LawranceSim/AQUASS-Flood-Detection-Alert-System/docs/System Design Project Portfolio (Group 7, AQUASS).pdf

4

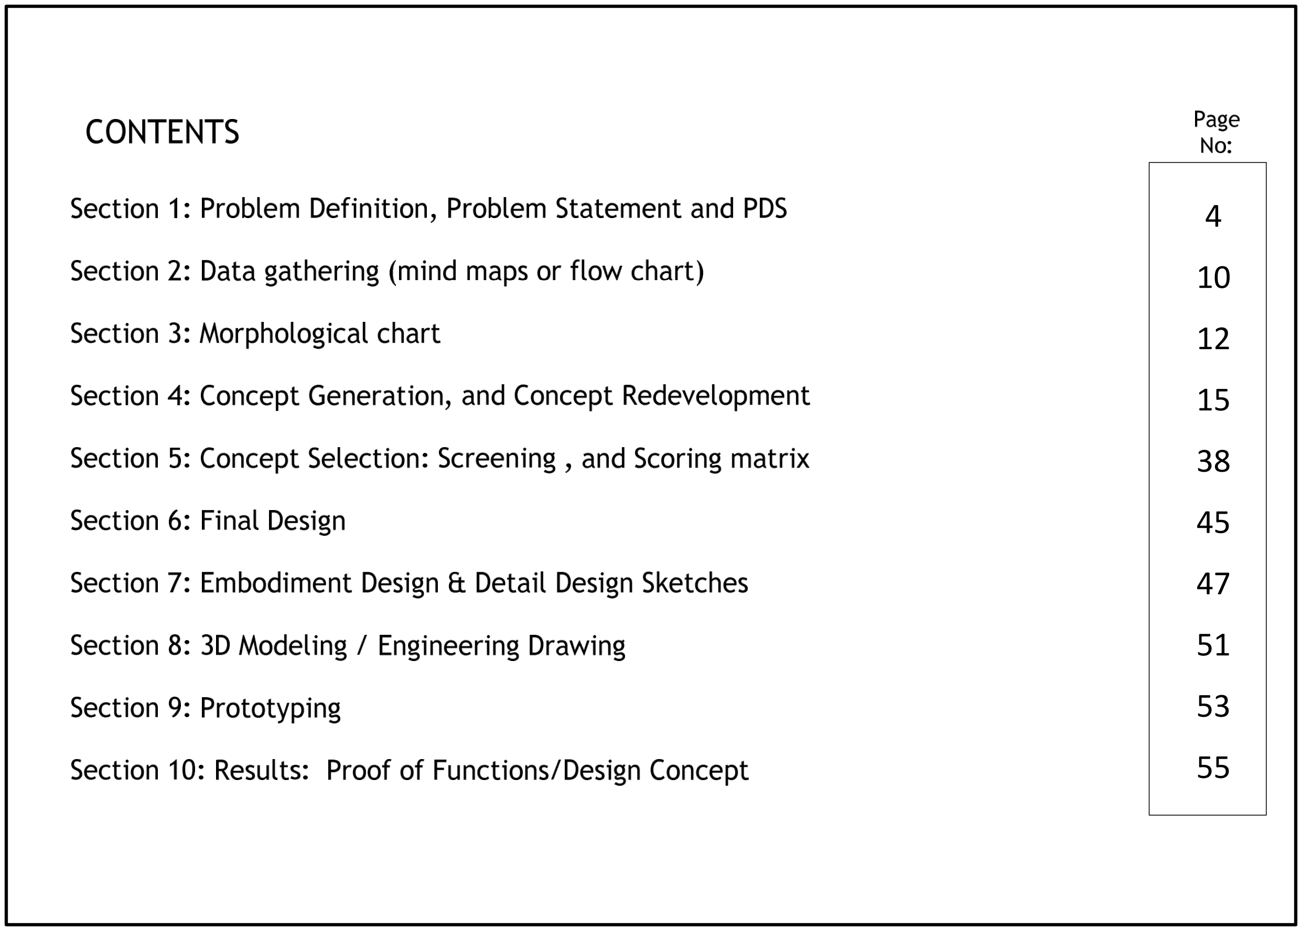
[picture p4: page 1]

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
## Problem Definition

## Design Project: Camper Site Flooding Safety System

## Project Background

## Campsites located near rivers, lakes, or low-lying areas face flooding risks, especially during heavy rainfall. Flooding can damage camping equipment, disrupt activities, and endanger campers. To improve safety, innovative design solutions are needed that are

practical, portable, and reliable in outdoor environments.

## Project Task

The primary objective of this project is for you to design and develop a solution that enhances the safety of campers during flooding events. The system should either pre vent or mitigate flooding risks at campsites, using a combination of mechanical engi neering solutions, Internet of Things (IoT) technology, or a hybrid of both. The solution will need to be practical, cost-effective, and scalable for real-world use

## Problem Statement

## The primary issue addressing this project is the critical absence of real-time, on-site monitoring systems at campsites. Current flood alert mechanisms operate on a macro scale, providing broad regional warnings that lack the granularity required for specific

campsite safety. This lack of localized data creates a significant notification delay, often

referred to as latency, between the onset of rising water levels and the reception of a warning. Consequently, campers are left with insufficient time to react, rendering them unable to evacuate before water levels become hazardous. This delay significantly increases the risk of entrapment, property damage, and casualty during flash flood

events.

To mitigate these risks, the proposed solution is the "AQUASS" system—a rugged IoT-based device designed specifically for continuous lakeside monitoring. The system is engineered to perform real-time water level analysis and autonomously execute a decision-making process based on safety thresholds. The core design philosophy focuses on a dual-alert mechanism that integrates immediate local sirens for on-site campers and remote Blynk notifications for off-site operators or authorities. This approach ensures reliable, all-weather operation and provides a redundant warning system to guarantee that alerts are received regardless of the campers' immediate

attentiveness.

Category | Specification | Description / Target / Rationale
Function | Flood detection and early warning | Detects rising water levels near campsites and triggers alerts for evacuation.
Application Area | Campsite or recreational sites near lakes | Fixed installation near potential flood-prone zones.
Performance requirements | Detection range | Detects water-level rise within 0–200 cm range with ±2% accuracy.
| Response time | Alert within ≤ 5 seconds after the danger threshold exceeded.
| Alert coverage | Local alert (LED, buzzer) audible within 30 m radius.
Power Requirement | Supply | 12V DC (solar + Li-ion battery backup).
| Operation time | Minimum 7 days continuous operation without sunlight.
| Power consumption | < 1.5 W average (low-power IoT mode).
Dimensions | Pole height | ≥ 1m
| Casing | Length ≤50 cm Width ≤50 cm Height ≤50 cm
Communication / Connectivity | Local and remote alerts | GSM or LoRa for off-grid sites; Wi-Fi optional where available.
| IoT integration | Blynk / ThingSpeak for data monitoring and notifications.

## Product Design Specifications (PDS)

Materials and Construction | Enclosure | Weatherproof IP65+ ABS/polycarbonate enclosure.
| Mounting | Fixed installation on pole or platform near riverbank.
| Environmental protection | UV-resistant, waterproof, and corrosion-proof materials.
Safety Requirements | Electrical safety | All low-voltage operation (≤12V DC).
| Environmental safety | Non-toxic, sealed components; no hazardous emissions.
| Human safety | Visual and audible alerts comply with campsite noise limits (<80 dB).
| Structural safety | Safety factor of the most critical point of the structure >3.5
Environmental Conditions | Operating temperature | 0°C to 60°C.
| Humidity | 10–95% RH, non-condensing.
| Weather resistance | Must function during heavy rain, humidity, and minor debris exposure.
Reliability and Maintenance | Reliability | System uptime ≥ 95% during continuous monitoring.
| Maintenance | Annual battery inspection; sensor calibration every 6 months.
| MTBF (Mean Time Between Failures) | ≥ 5000 hours.
Ergonomics and Usability | User interface | Simple visual indicator (LED status) and mobile notification.
| Installation | Quick installation (≤ 6 hours) with minimal tools and instructions.
| Accessibility | Accessible maintenance port with waterproof seals.
Aesthetic / Design Factors | Design form | Compact and have eye-catching colour such as white.
| Visibility | LED indicators visible in daylight and night.

Standards / Compliance | Electrical & communication | Compliant with CE, FCC IoT, and IP65 standards.
| SDG alignment | Supports SDG 13 (Climate Action) and SDG 11 (Sustainable Communities).
Cost Target | Prototype cost | ≤ RM 400 per unit (excluding solar panel).
| Large-scale deployment | Target ≤ RM 500 per unit in production (excluding microcontroller / microprocessor, wirings).
Constraints | Location constraint | Installed within 1m from the water body for accurate monitoring.
| Power source constraint | Dependent on solar exposure; must ensure energy balance.
| Communication constraint | GSM coverage required if LoRa is not available.
Testing and Validation | Validation methods | Simulated flood tank testing, field trial at real campsite.
| Key performance indicators | Detection accuracy, alert reliability, power endurance, communication stability.

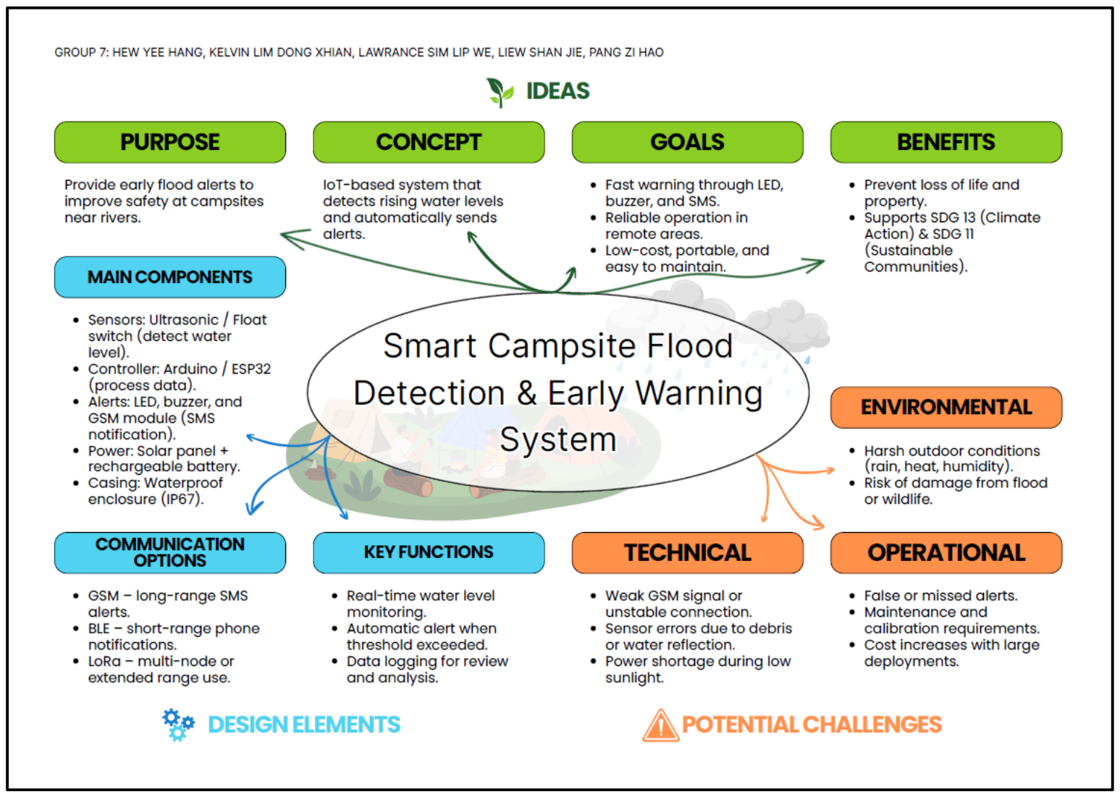
[picture p5: page 9]

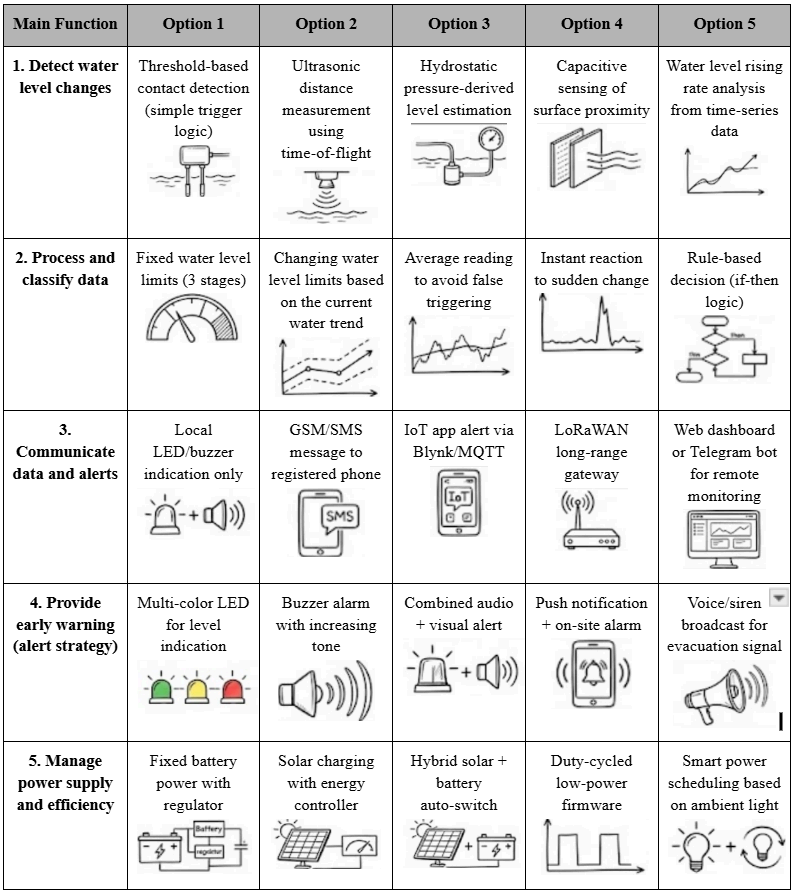
[picture p6: figure]

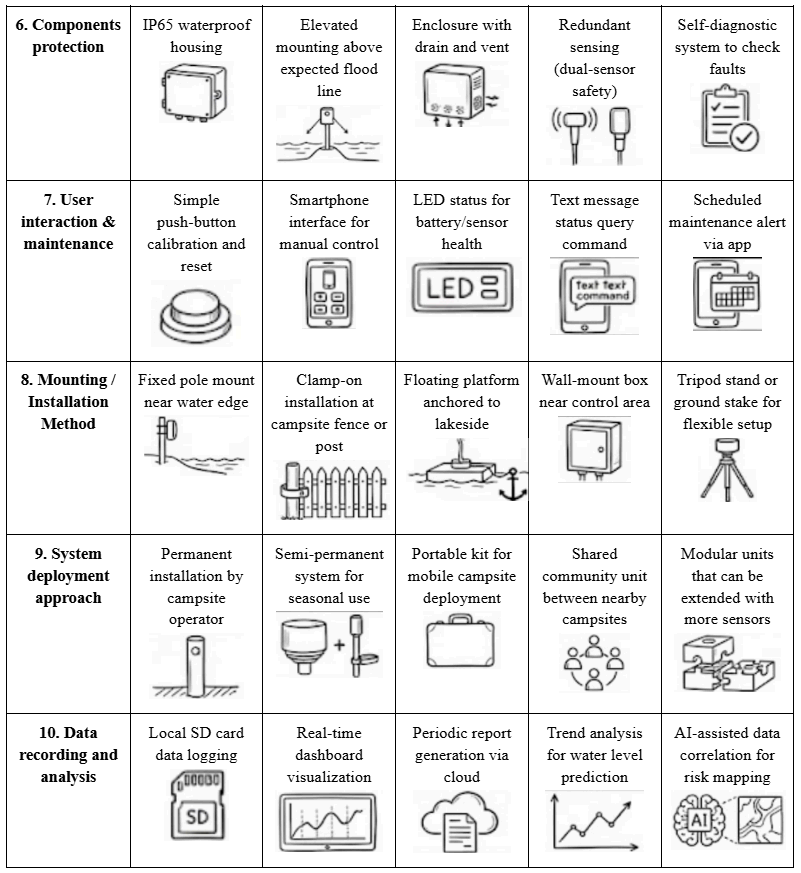
[picture p7: figure]

# Concept Generation

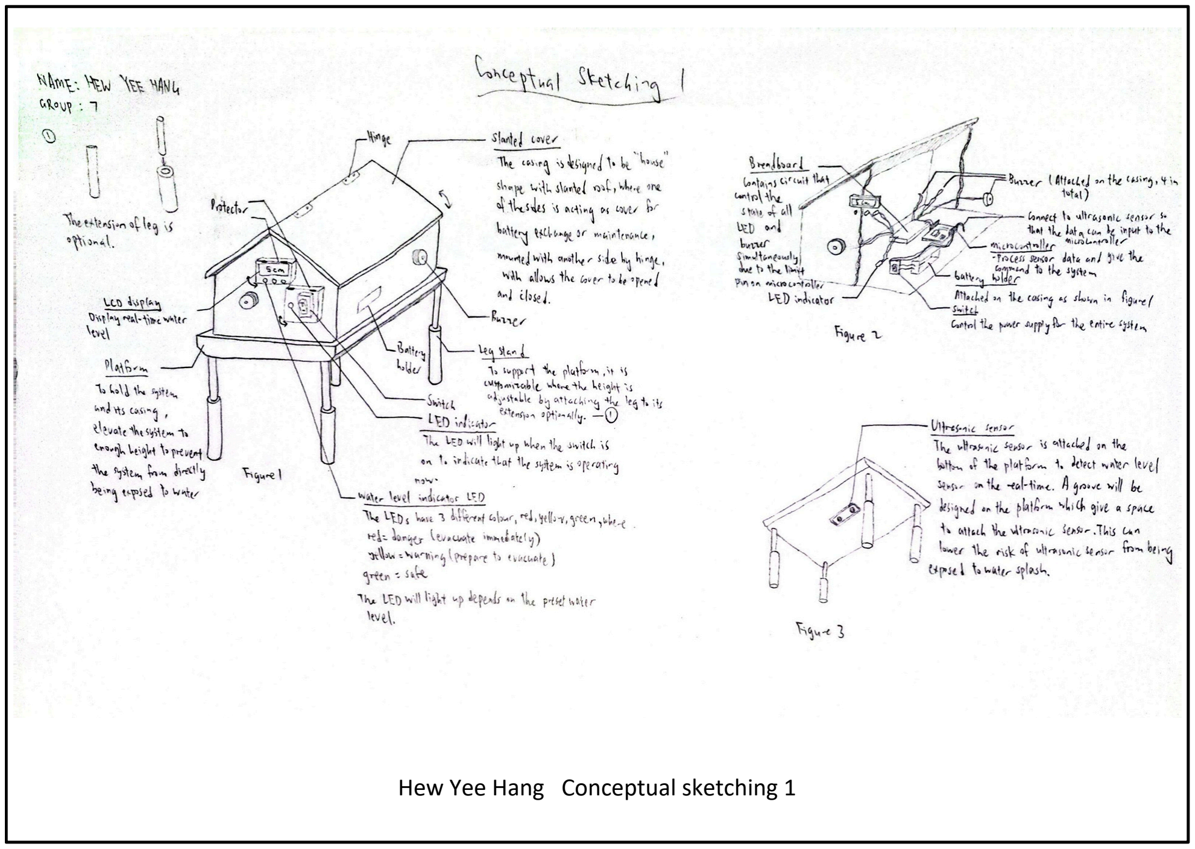
[picture p8: page 15]

Hew Yee Hang Conceptual sketching 1

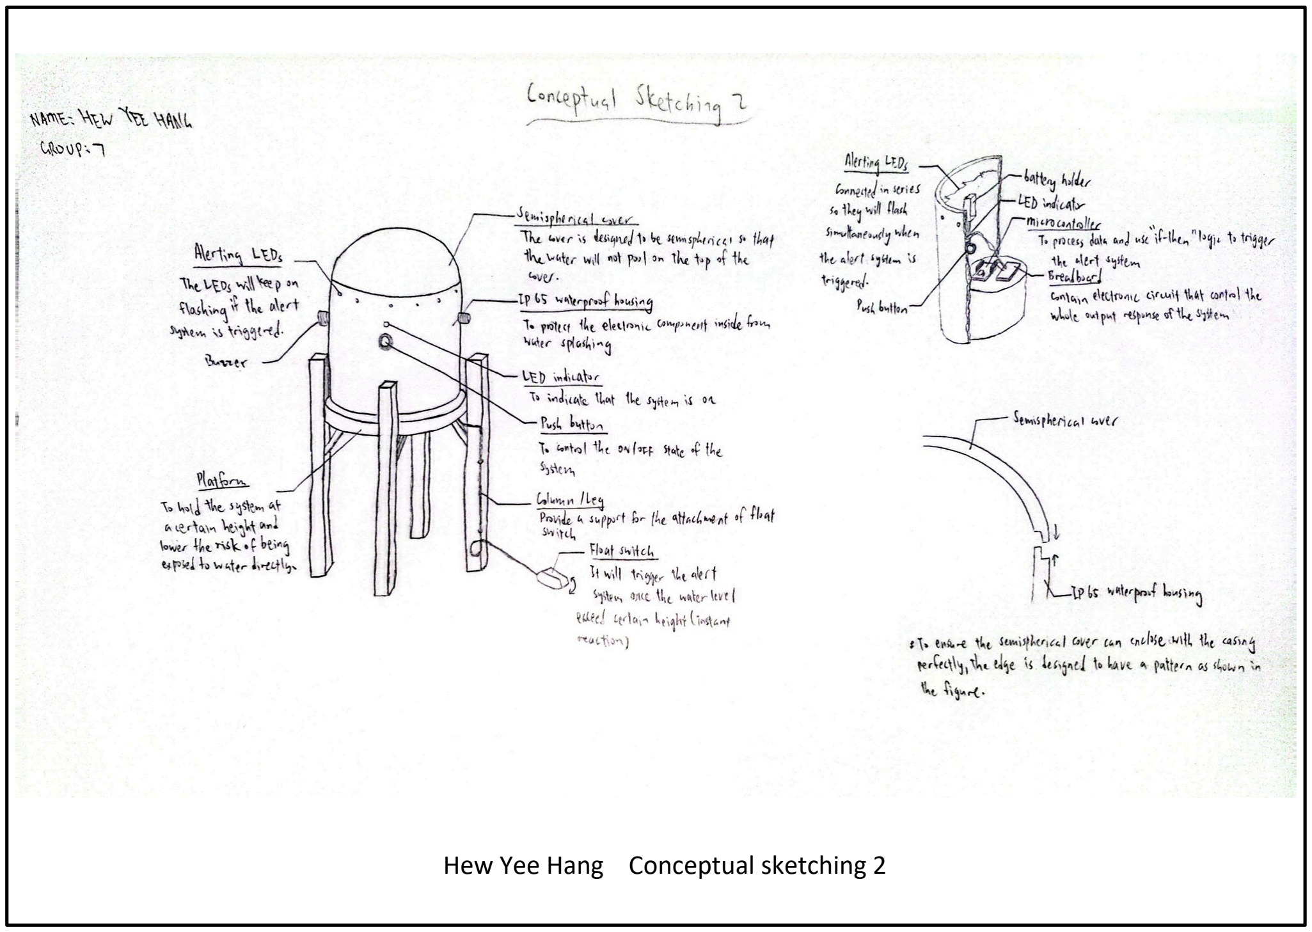
[picture p9: page 16]

Hew Yee Hang Conceptual sketching 2

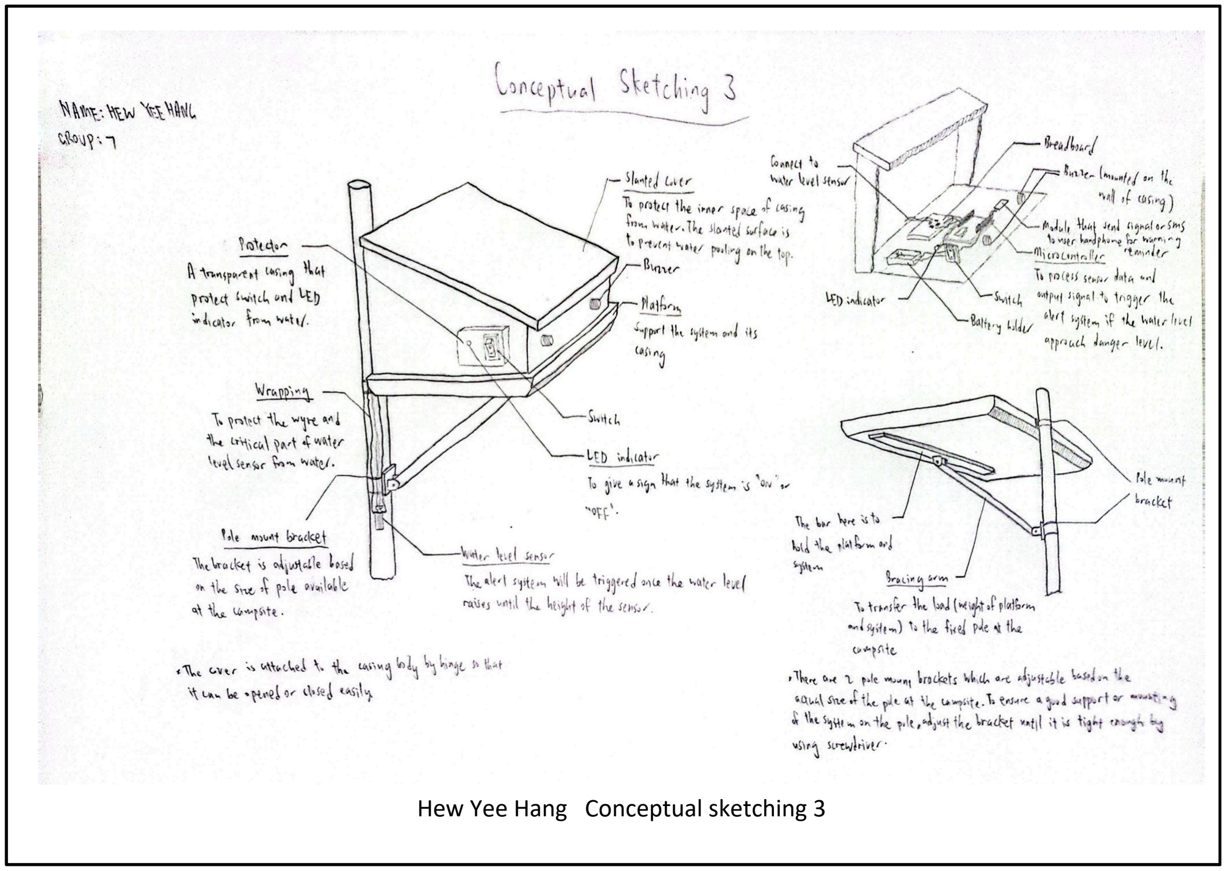
[picture p10: page 17]

Hew Yee Hang Conceptual sketching 3

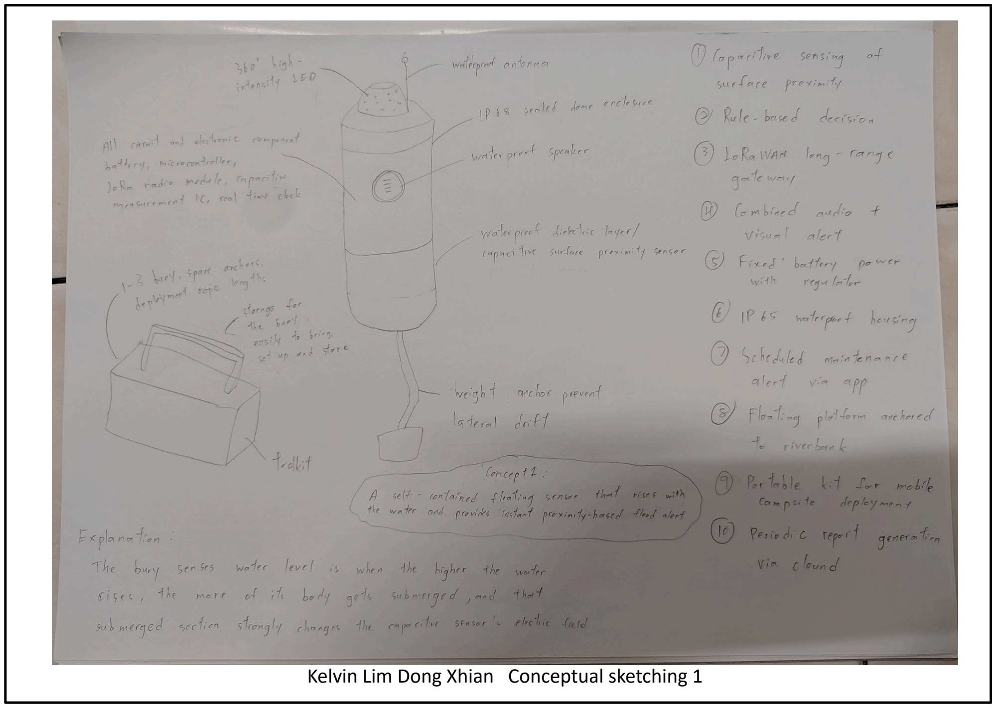
[picture p11: page 18]

Kelvin Lim Dong Xhian Conceptual sketching 1

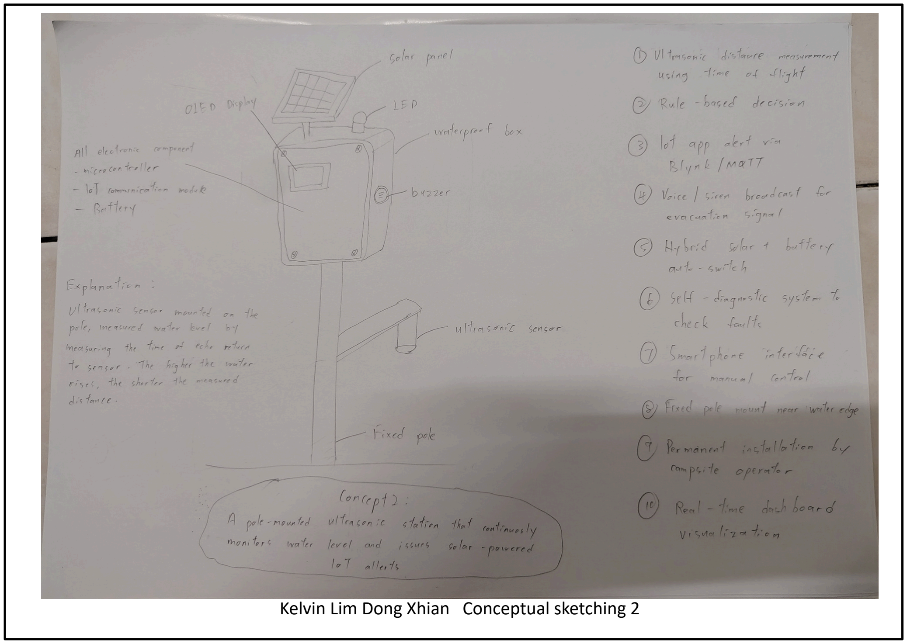
[picture p12: page 19]

Kelvin Lim Dong Xhian Conceptual sketching 2

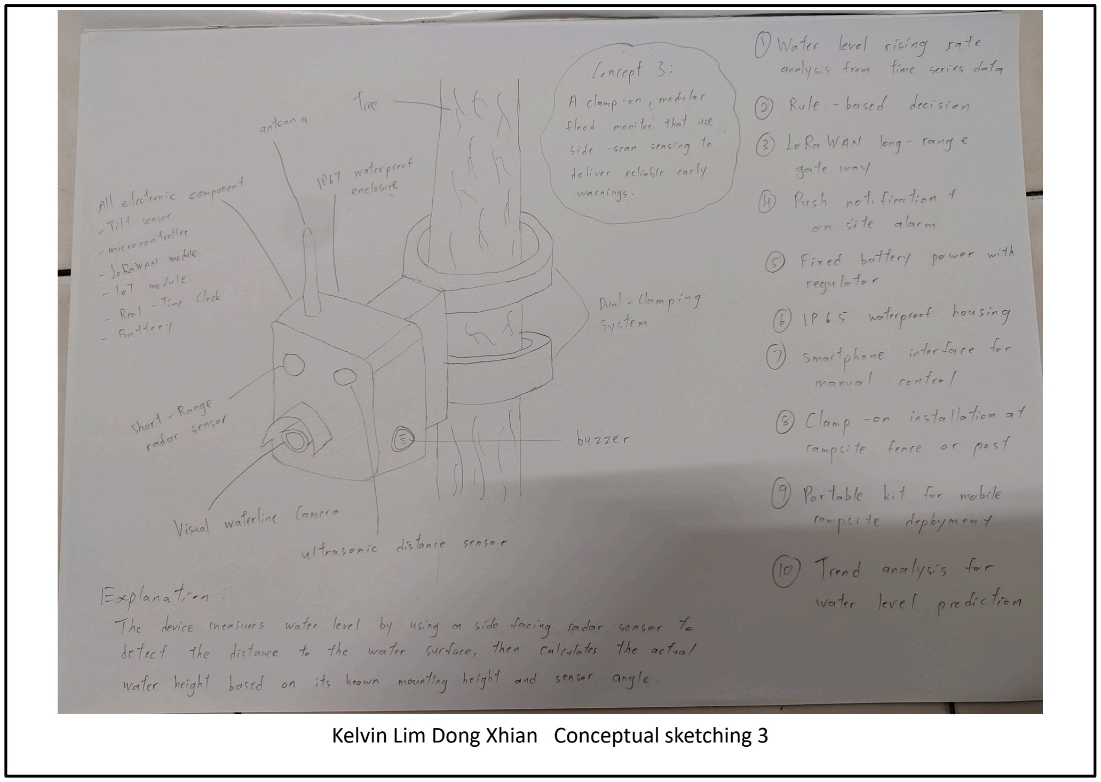
[picture p13: page 20]

Kelvin Lim Dong Xhian Conceptual sketching 3

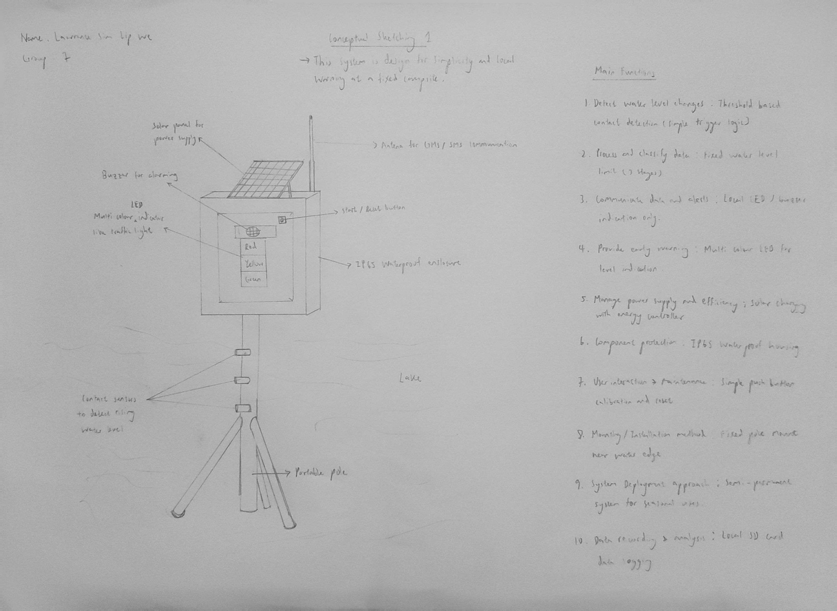
[picture p14: page 21]

Lawrance Sim Lip We Conceptual sketching 1

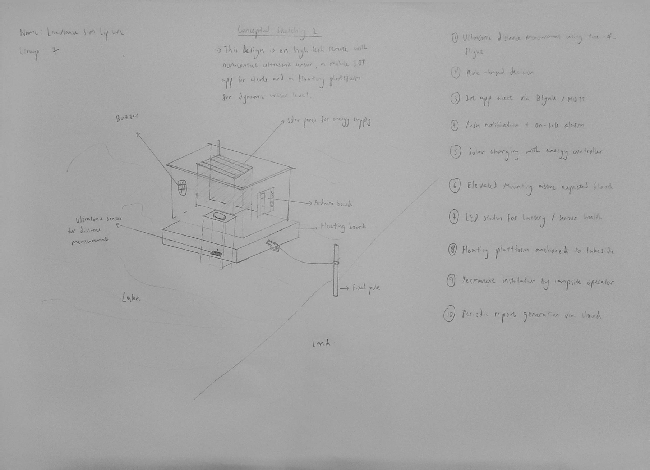
[picture p15: page 22]

Lawrance Sim Lip We Conceptual sketching 2

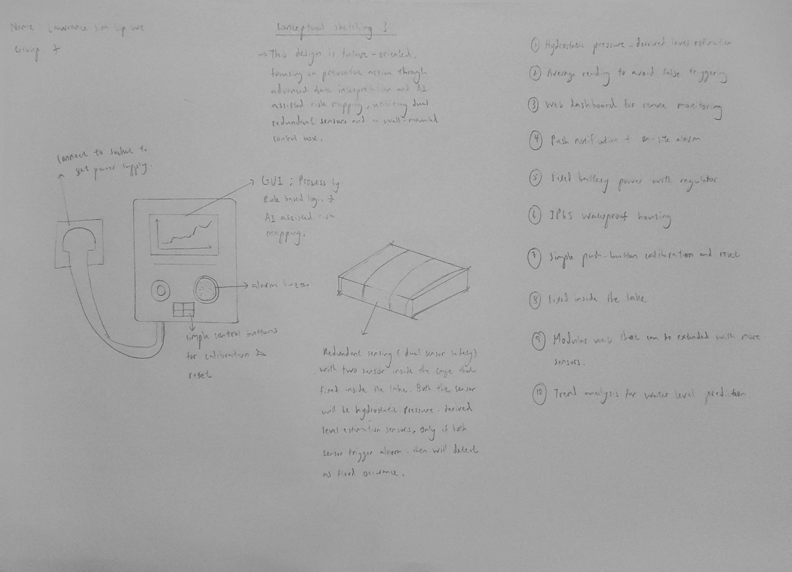
[picture p16: page 23]

Lawrance Sim Lip We Conceptual sketching 3

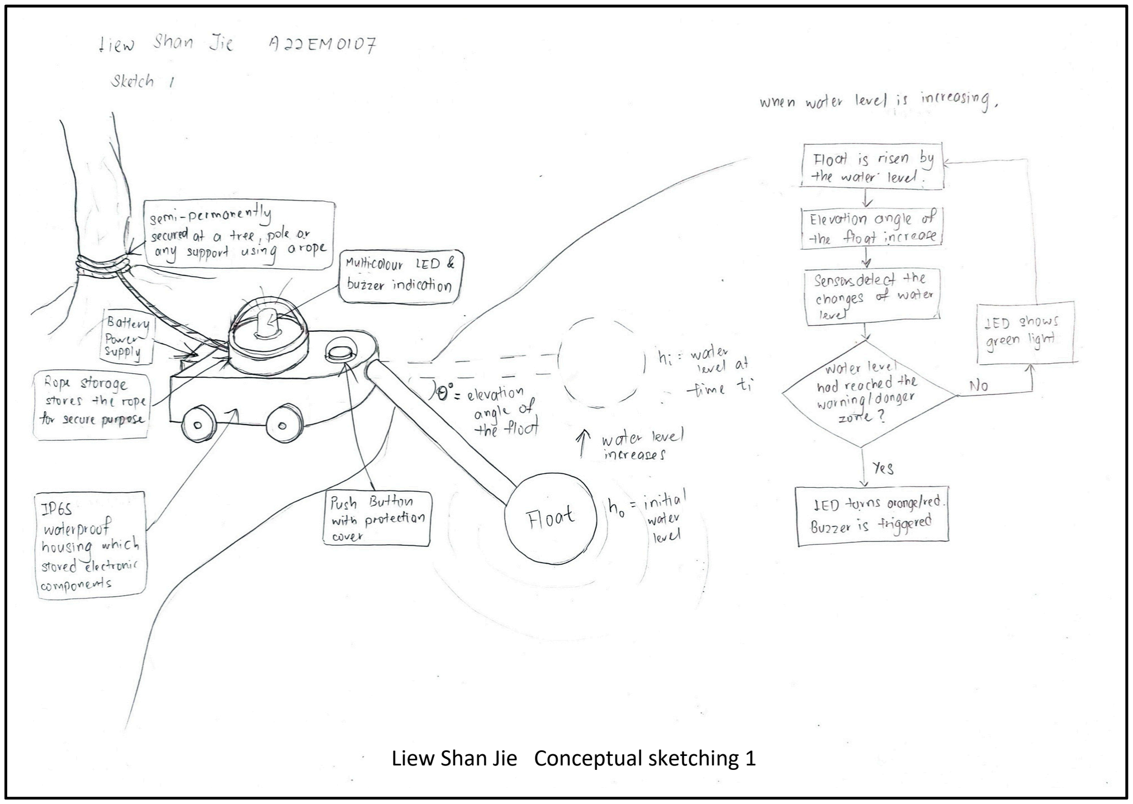
[picture p17: page 24]

Liew Shan Jie Conceptual sketching 1

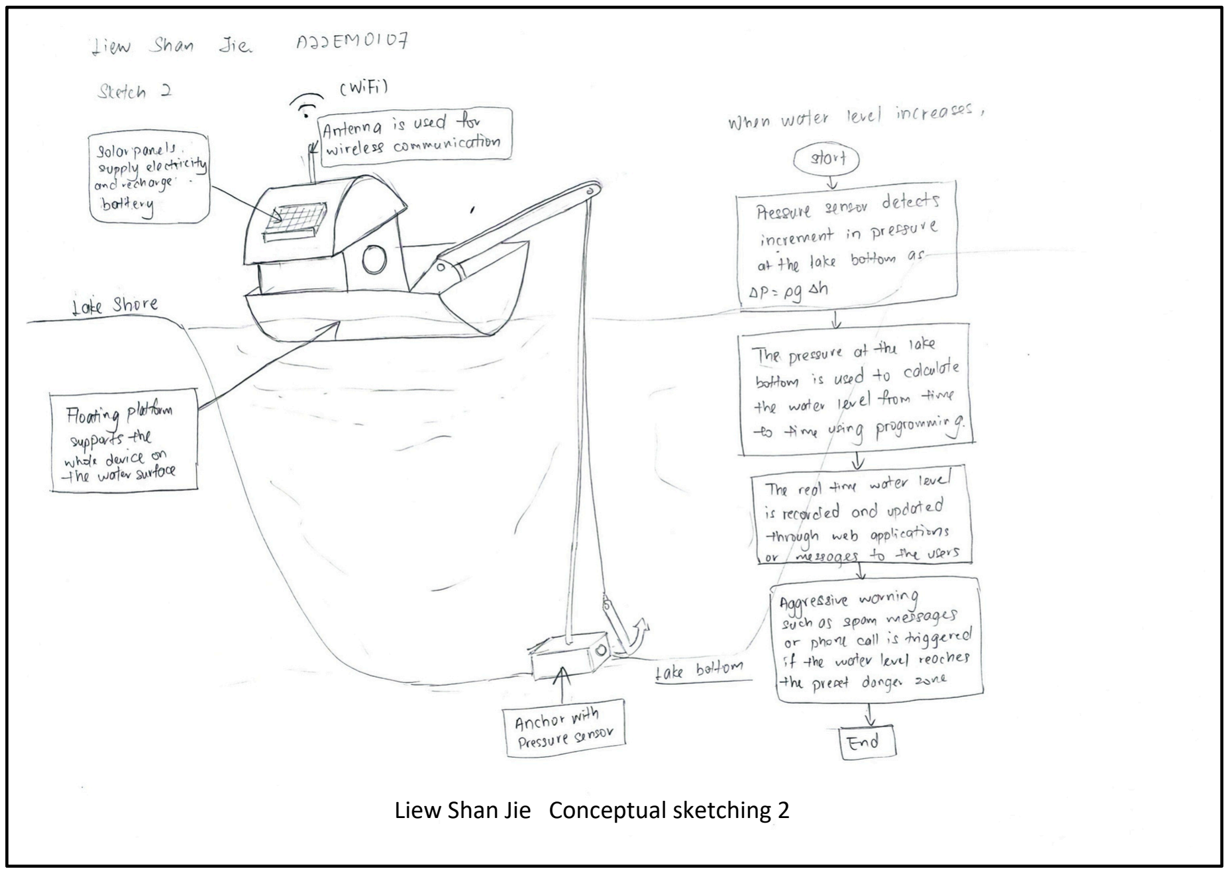
[picture p18: page 25]

Liew Shan Jie Conceptual sketching 2

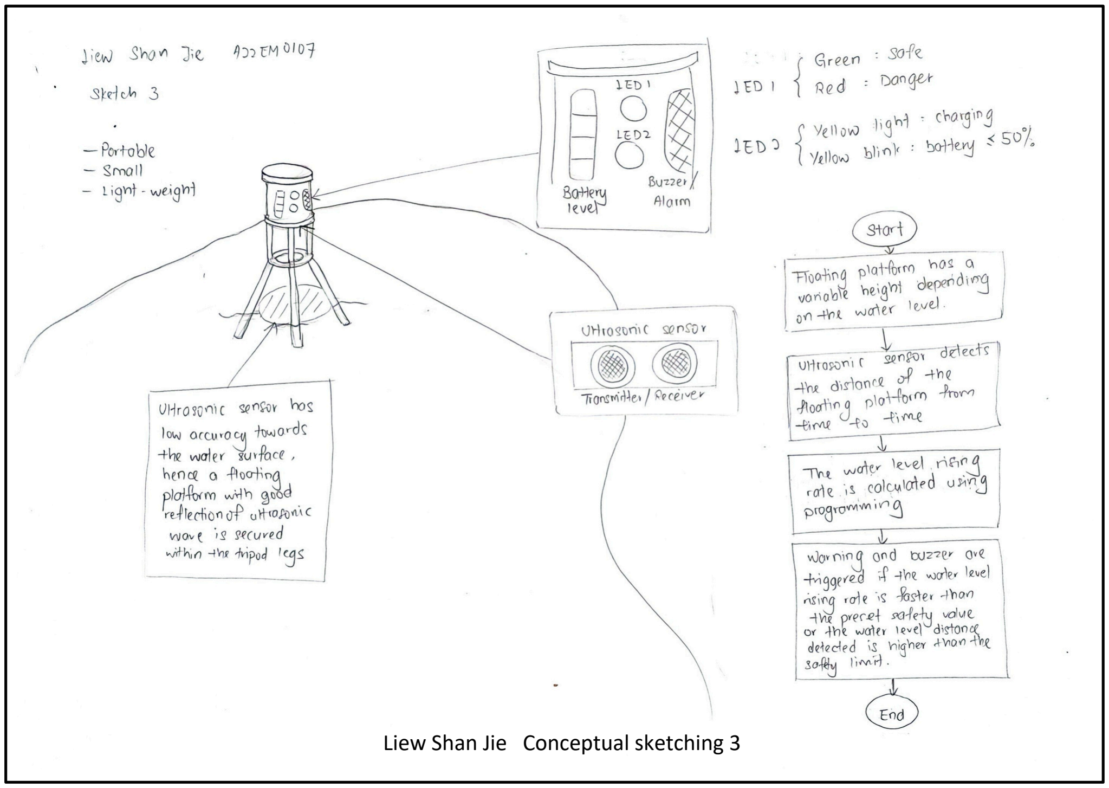
[picture p19: page 26]

Liew Shan Jie Conceptual sketching 3

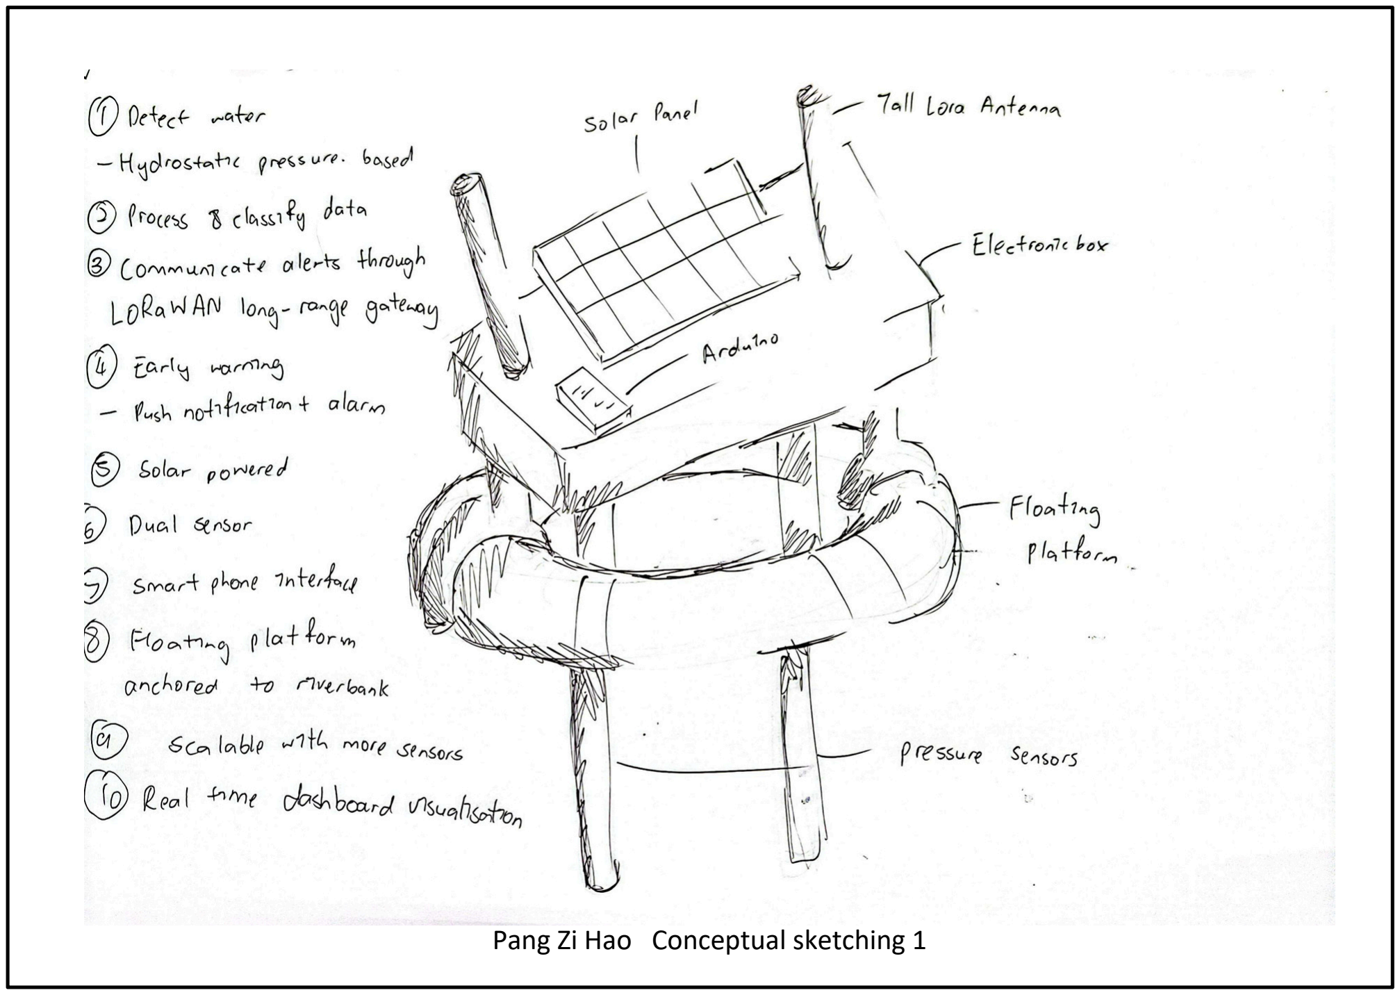
[picture p20: page 27]

Pang Zi Hao Conceptual sketching 1

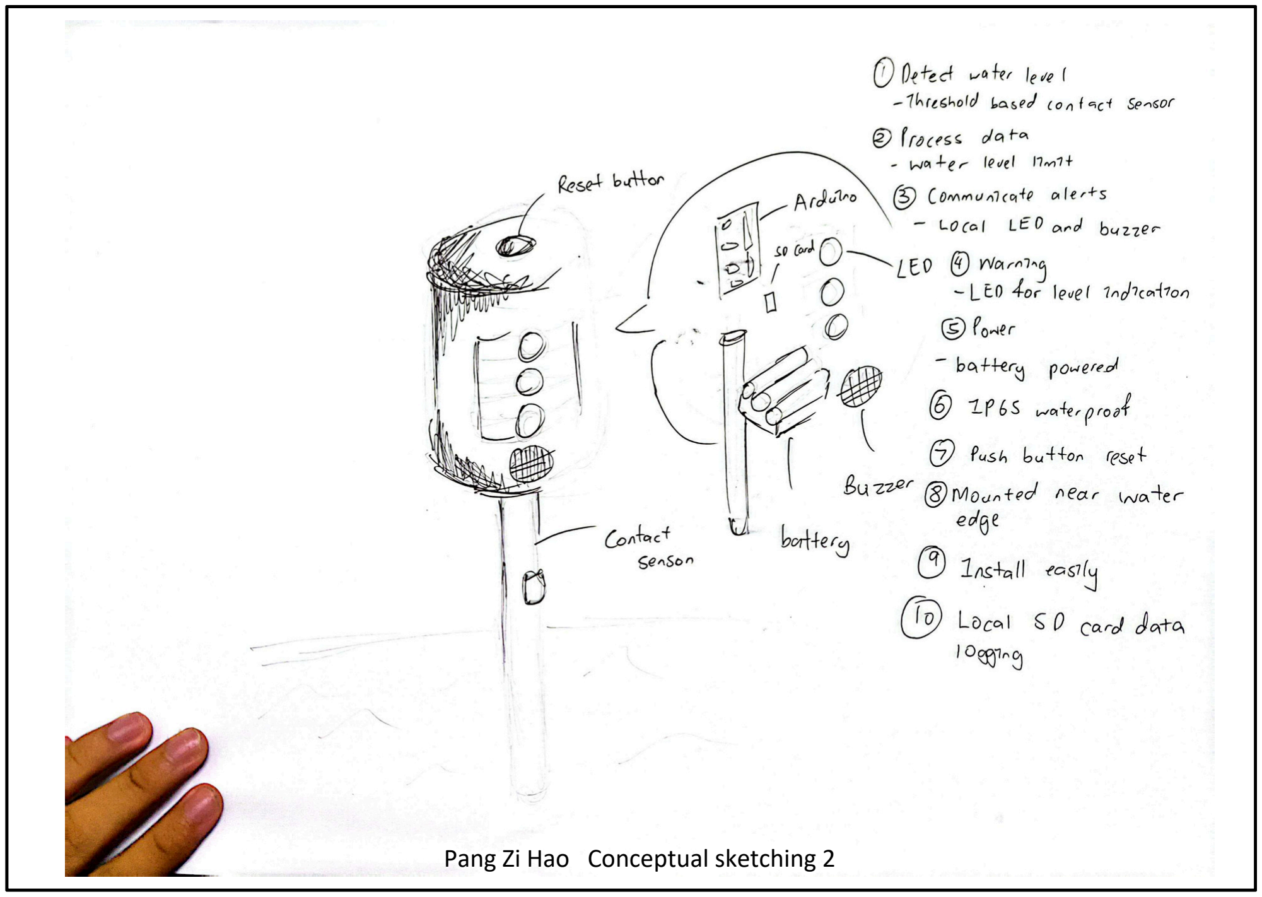
[picture p21: page 28]

Pang Zi Hao Conceptual sketching 2

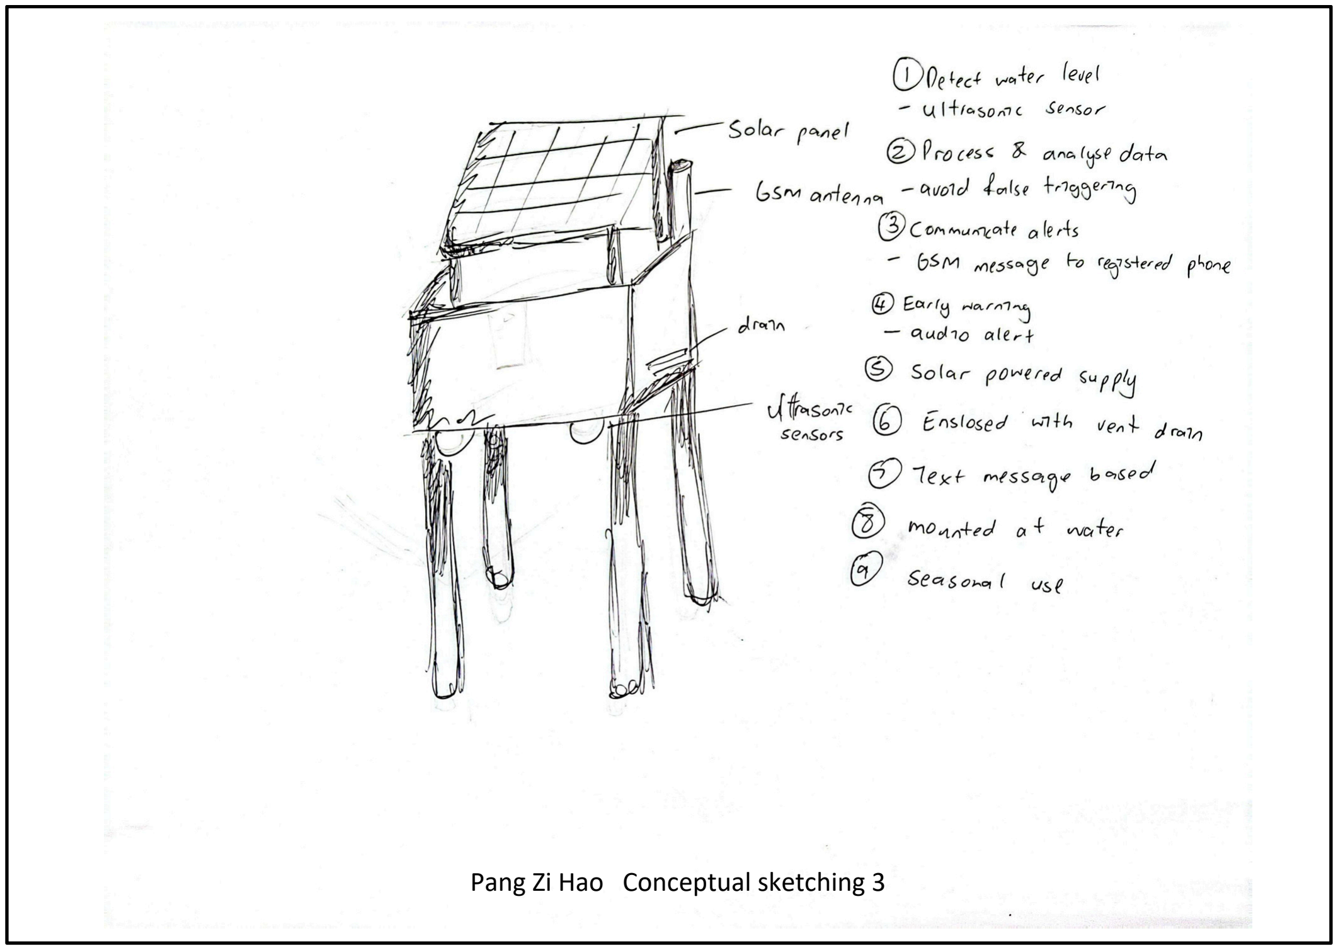
[picture p22: page 29]

Pang Zi Hao Conceptual sketching 3

# Concept Redevelopment

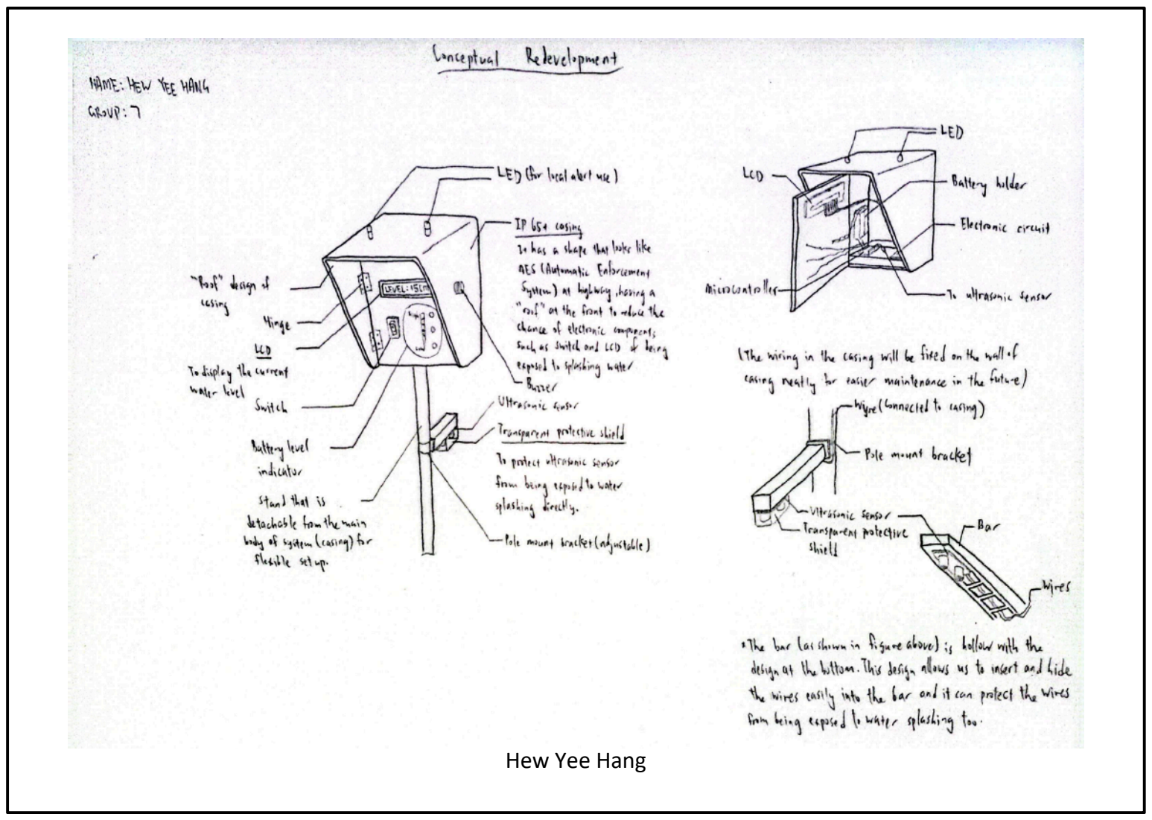
[picture p23: page 31]

Hew Yee Hang

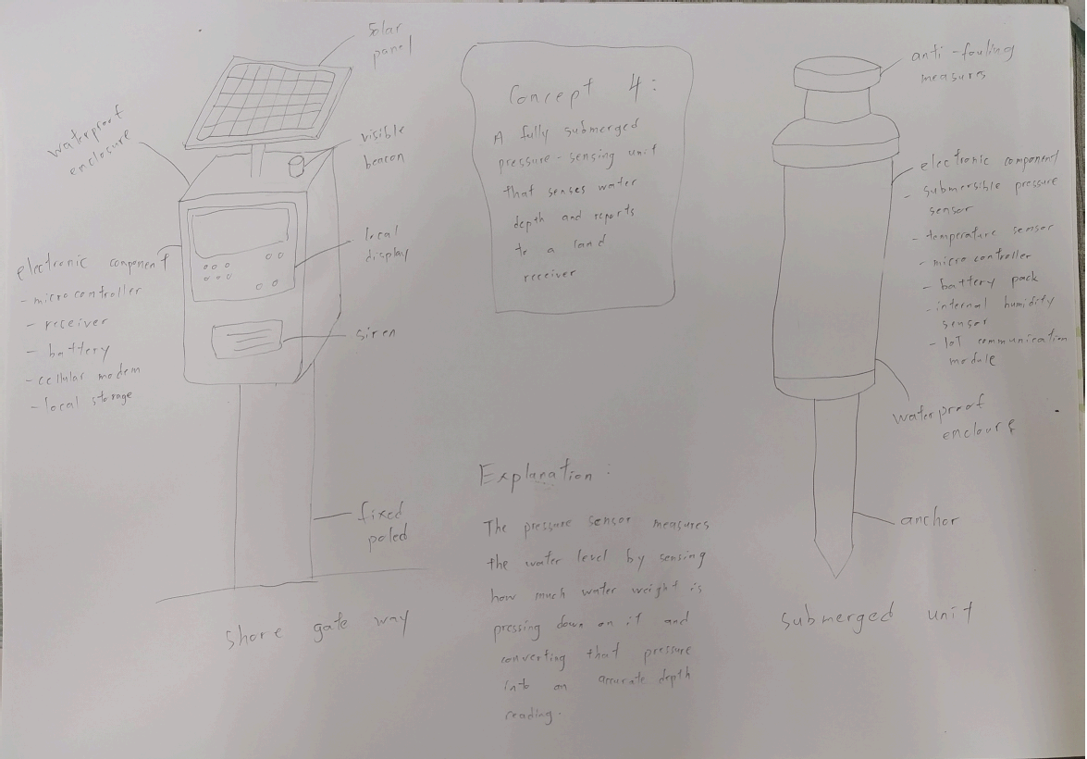
[picture p24: page 32]

Kelvin Lim Dong Xhian

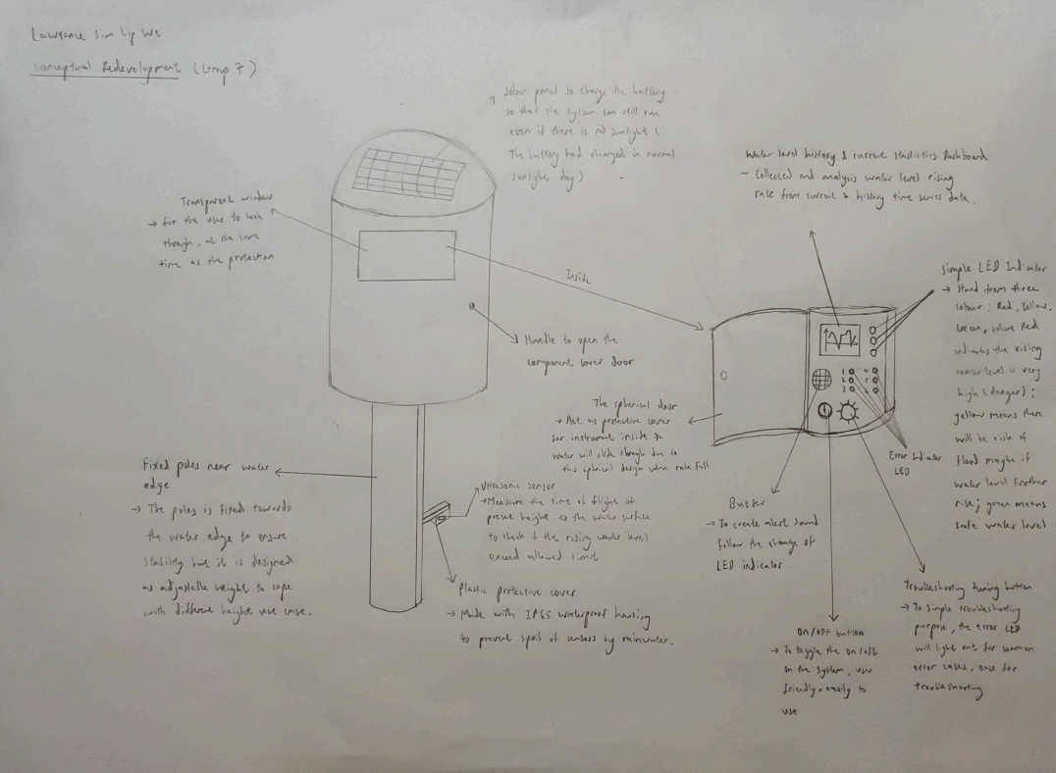
[picture p25: page 33]

Lawrance Sim Lip We

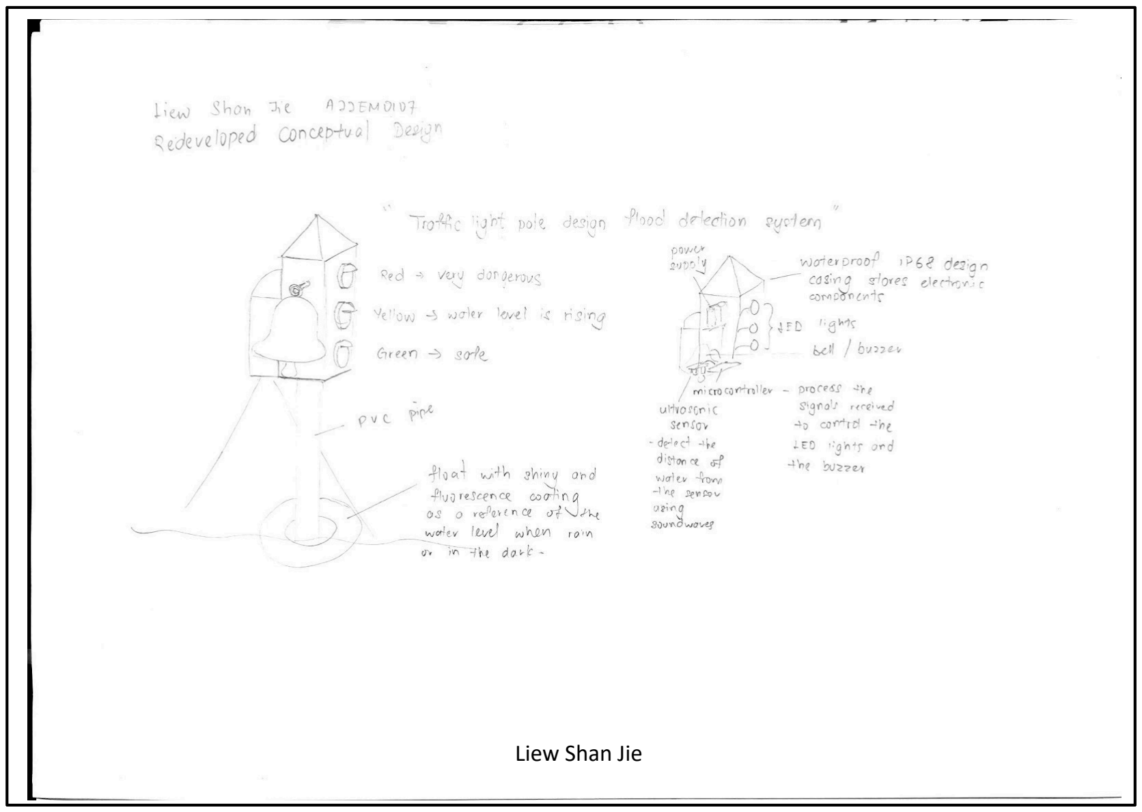
[picture p26: page 34]

Liew Shan Jie

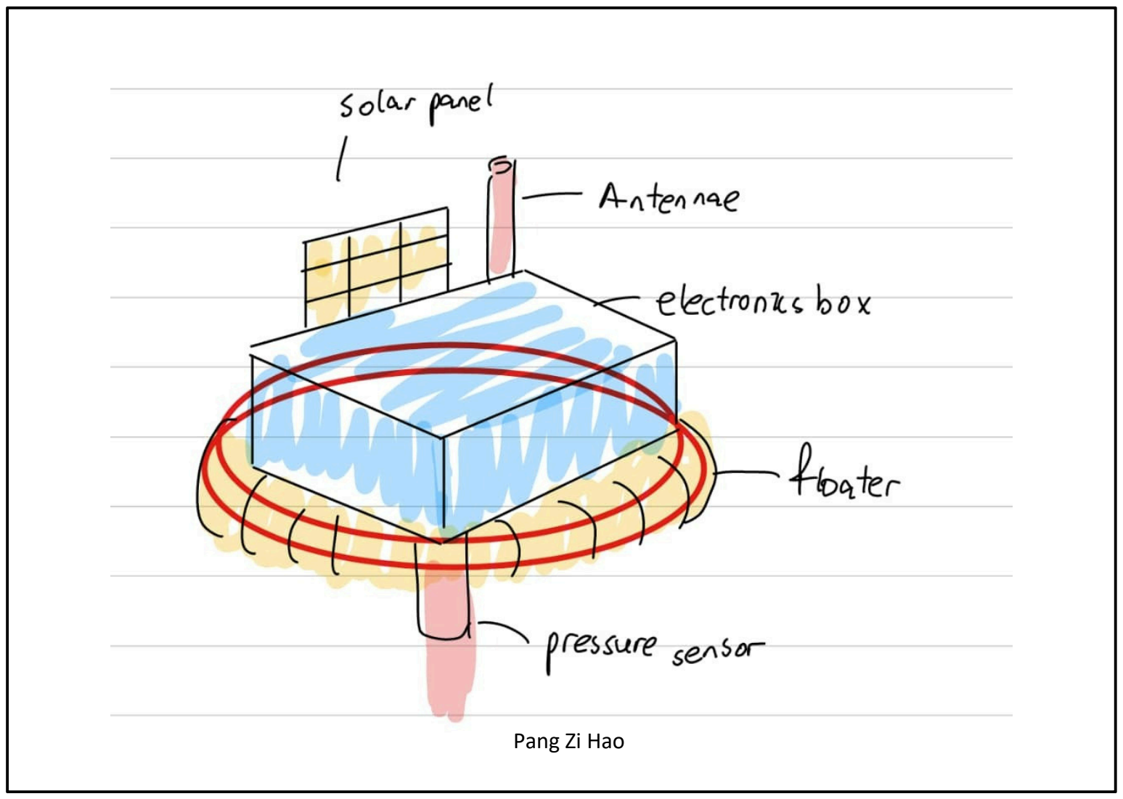
[picture p27: page 35]

Pang Zi Hao

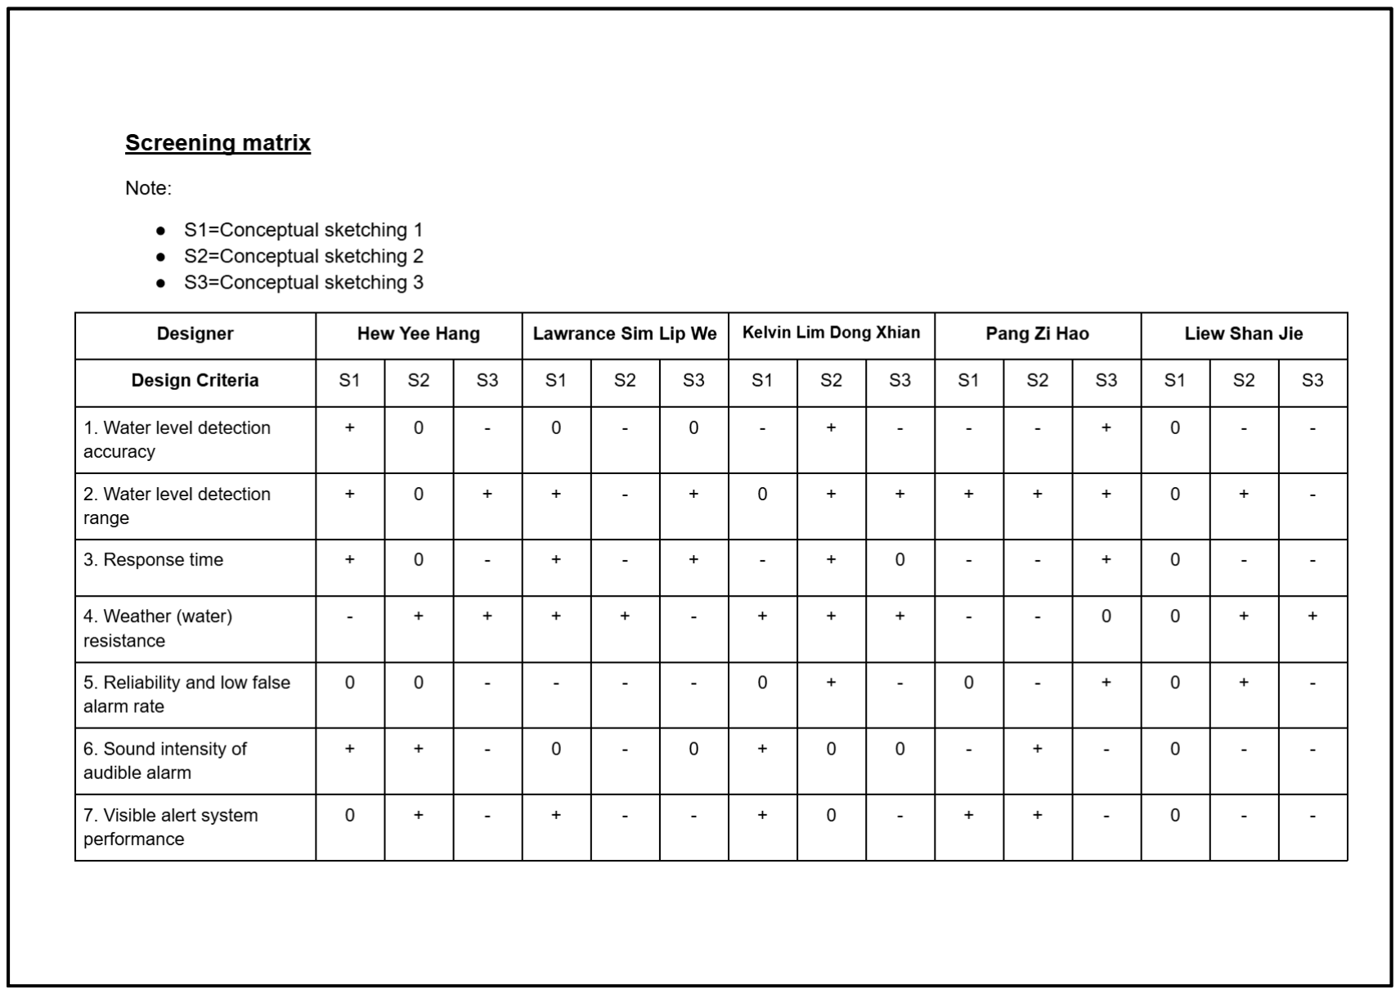
[picture p28: page 37]

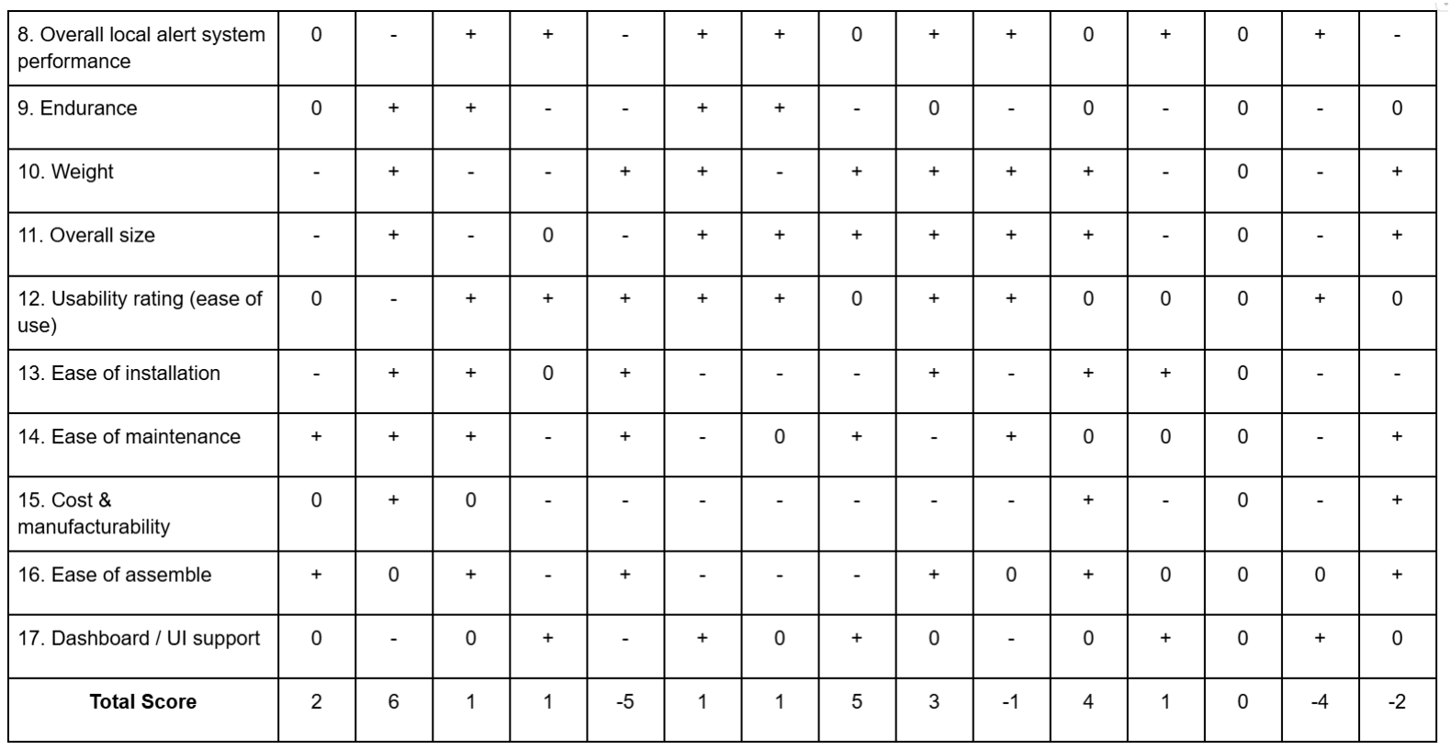
[picture p29: figure]
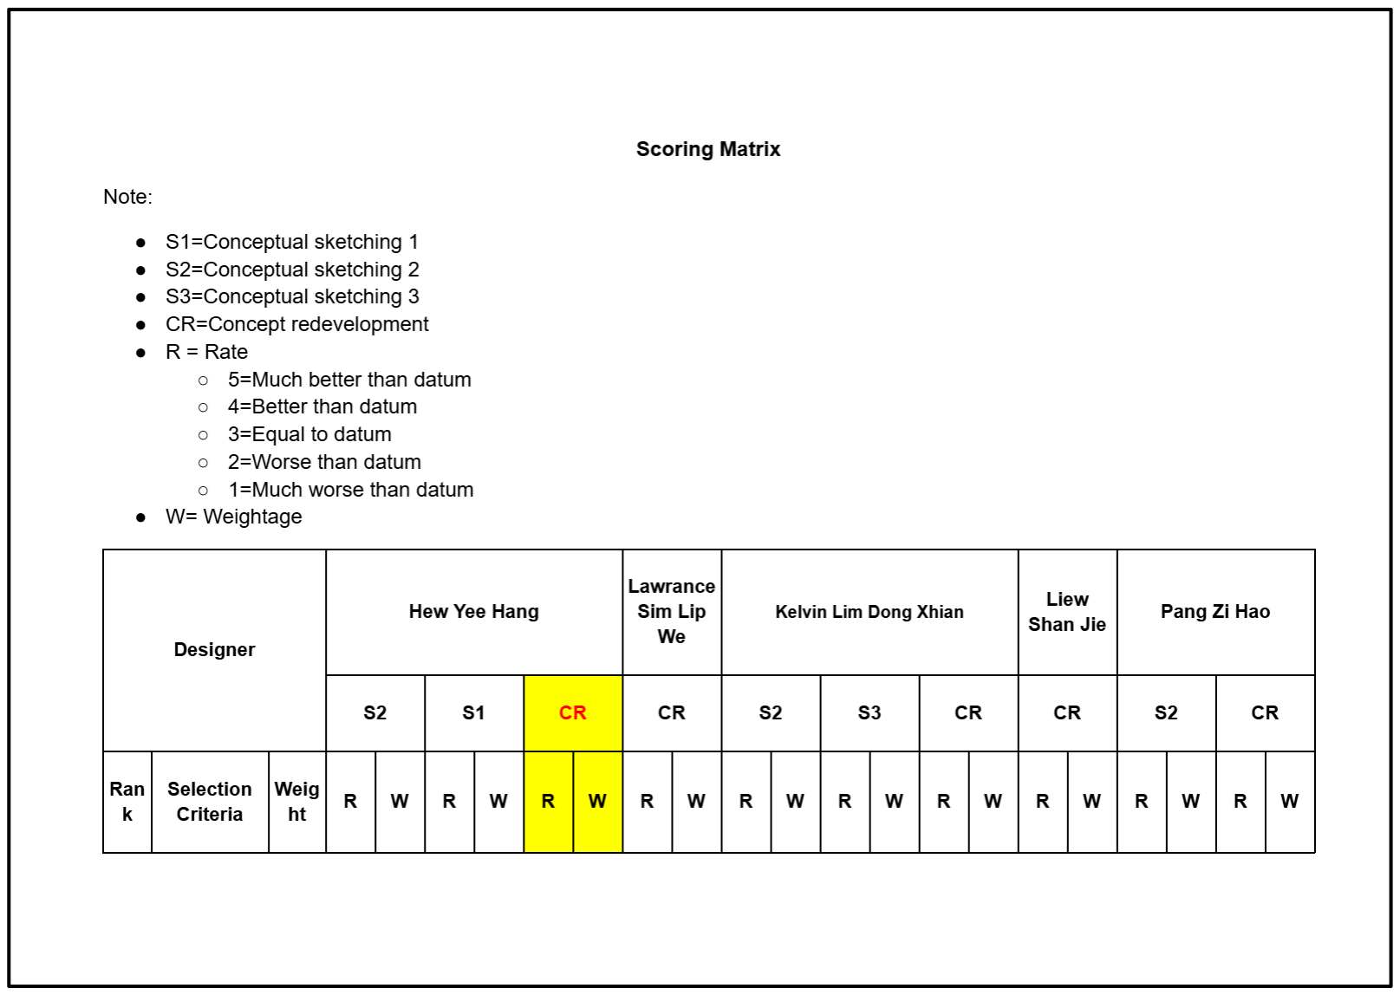
[picture p30: page 39]
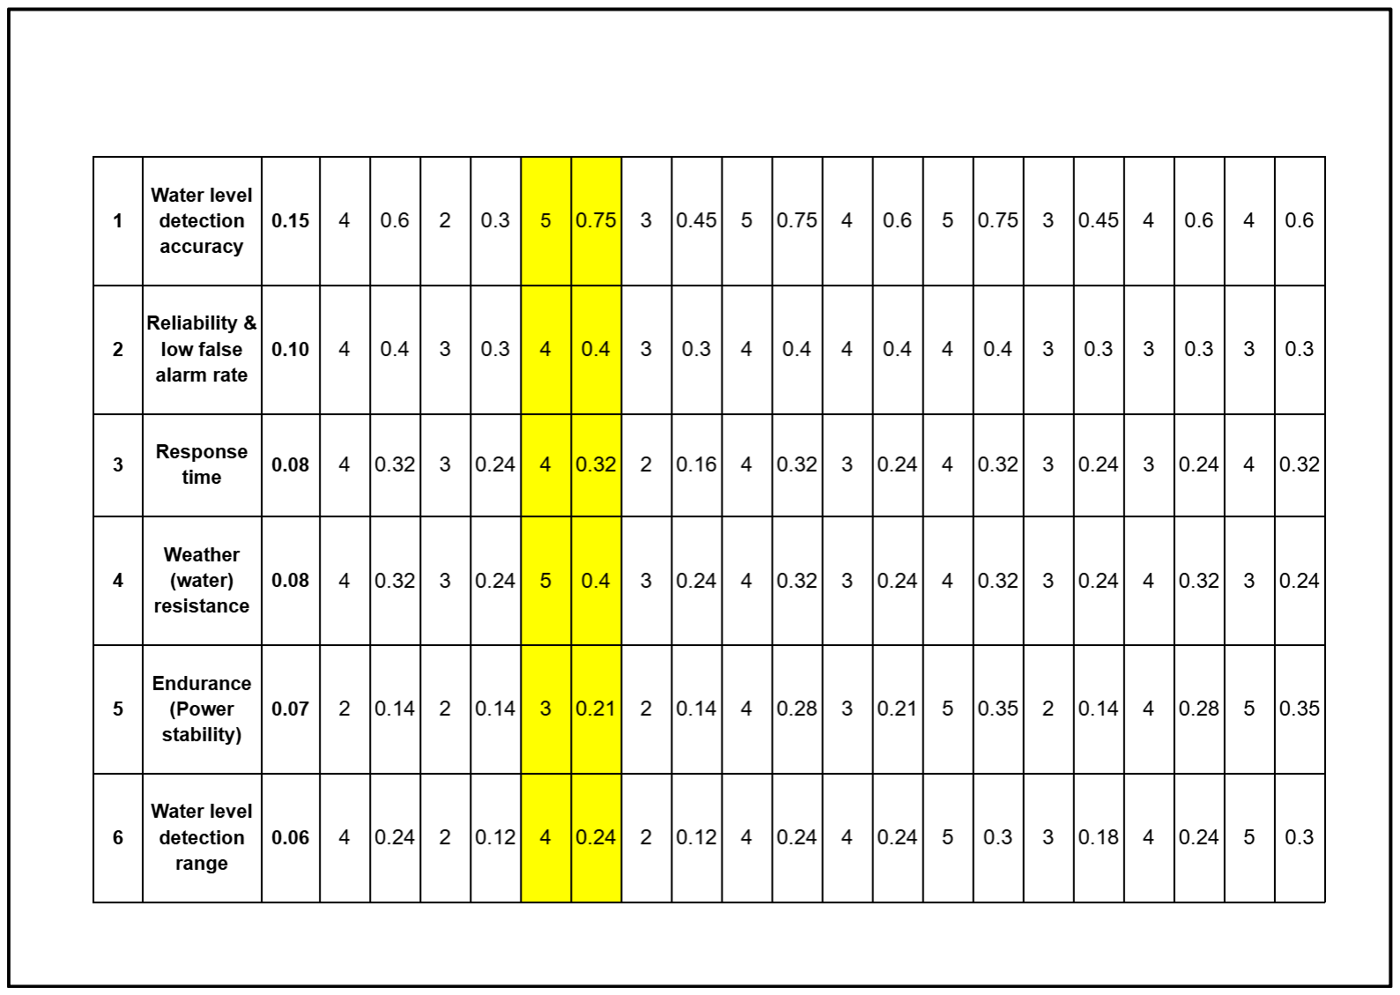
[picture p31: page 40]

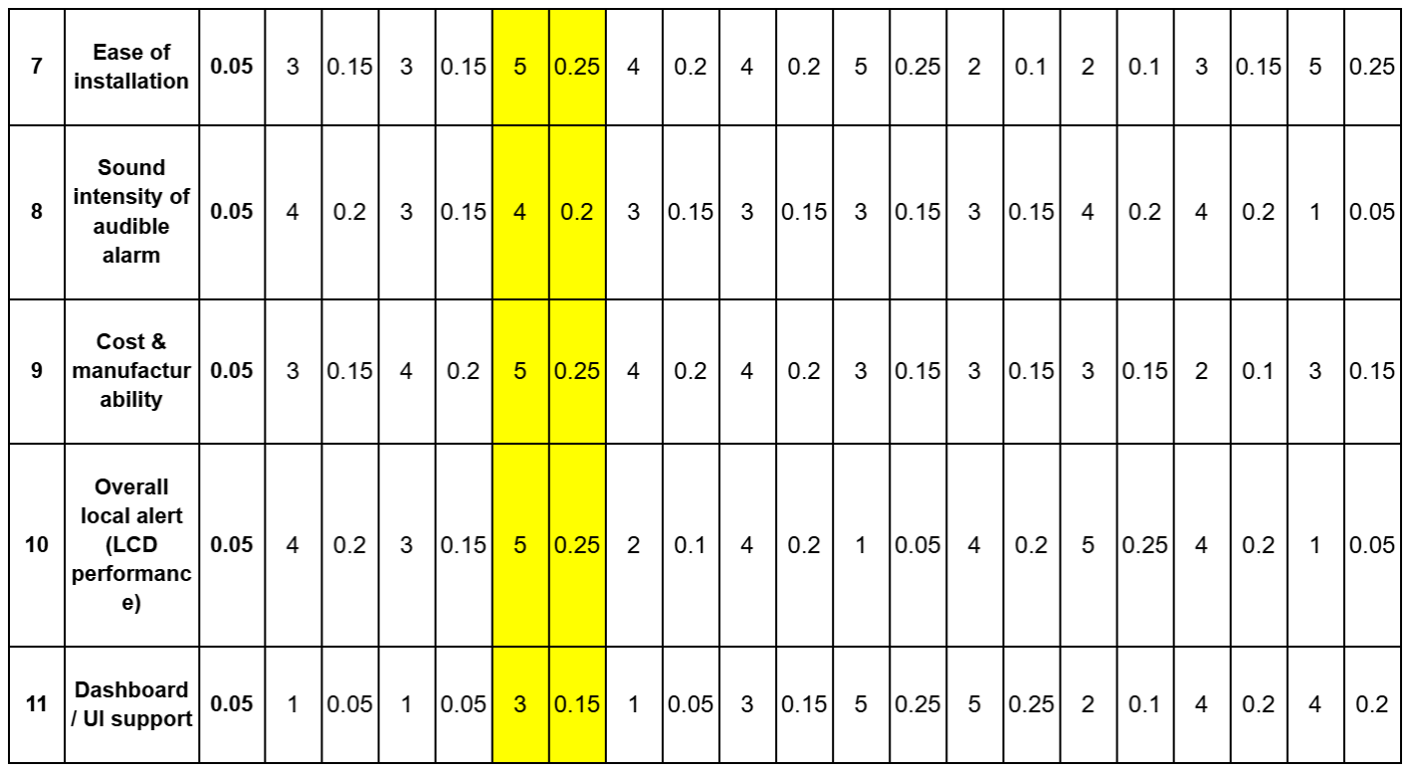
[picture p32: figure]
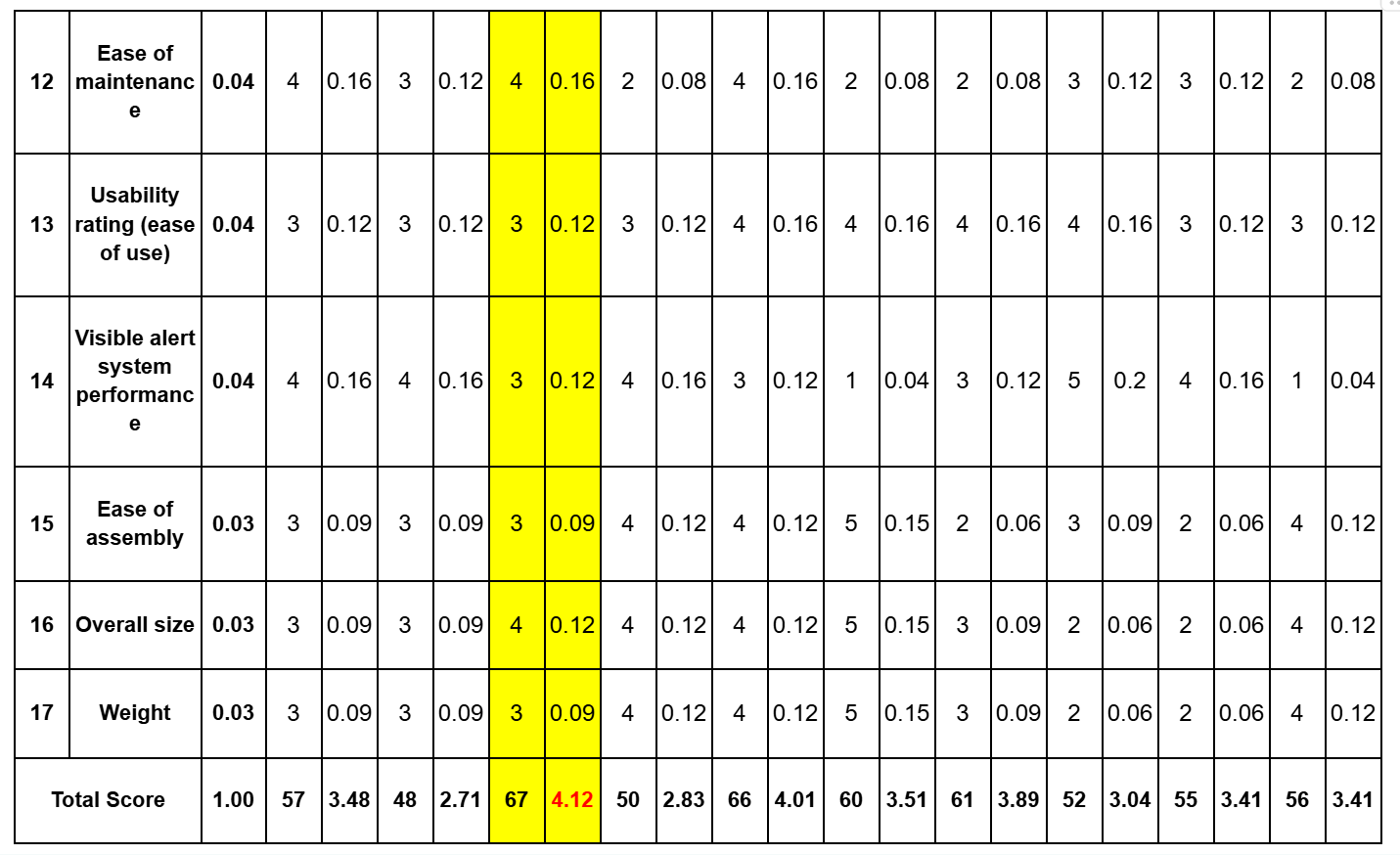
[picture p33: page 42]

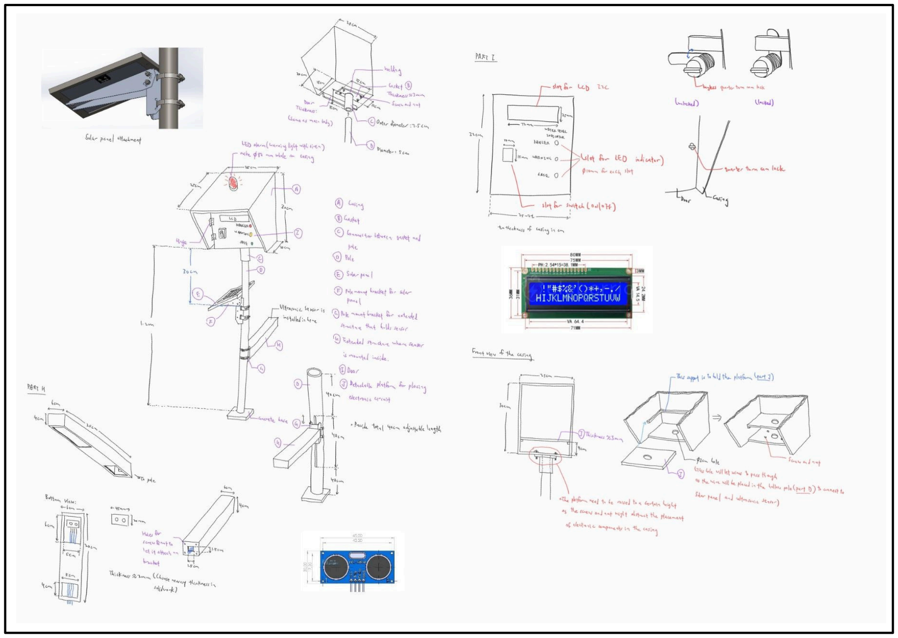
[picture p34: page 44]

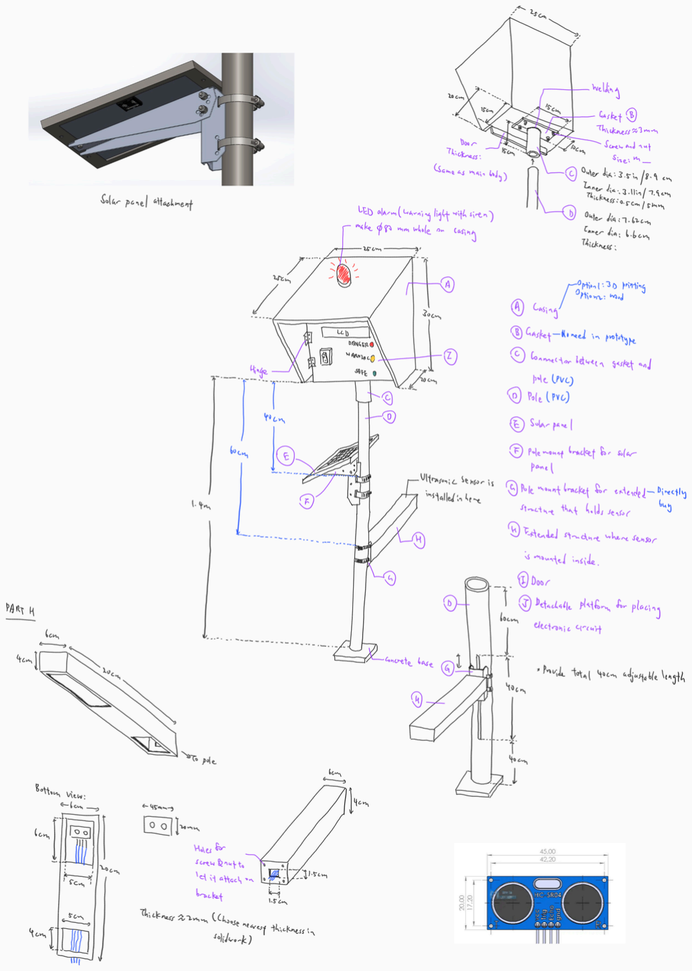
[picture p35: figure]

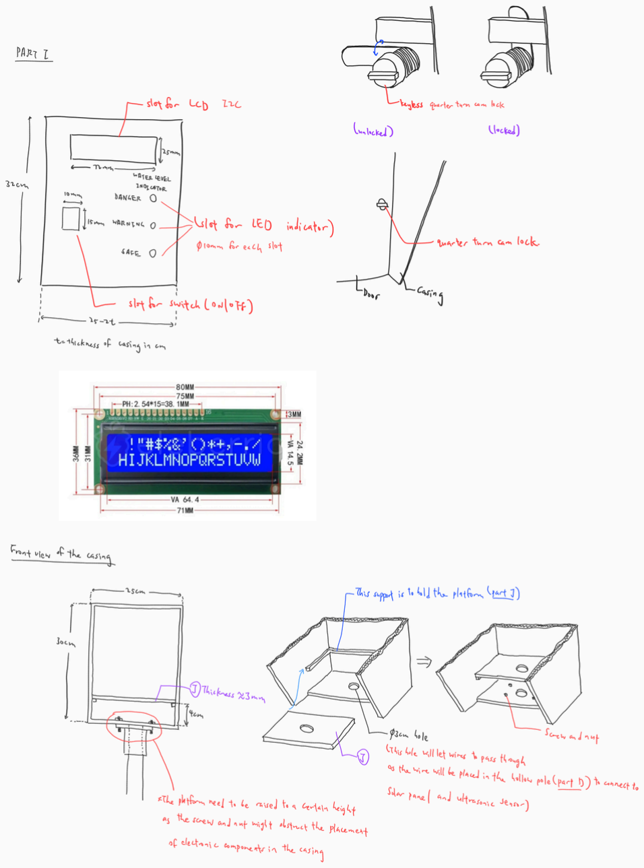
[picture p36: figure]

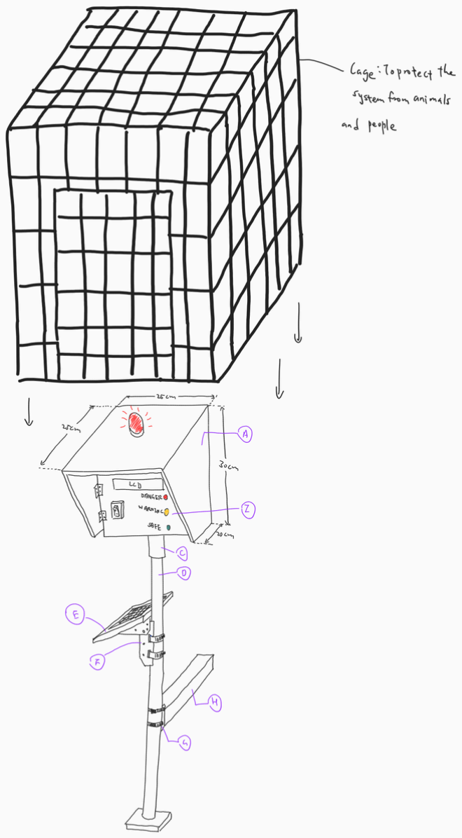
[picture p37: figure]

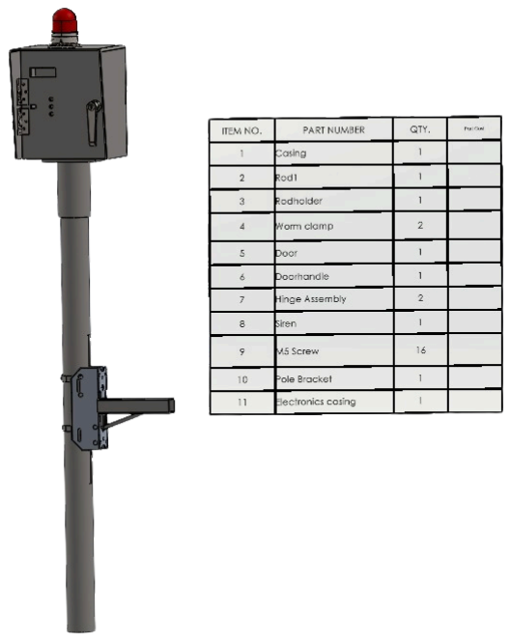
[picture p38: figure]

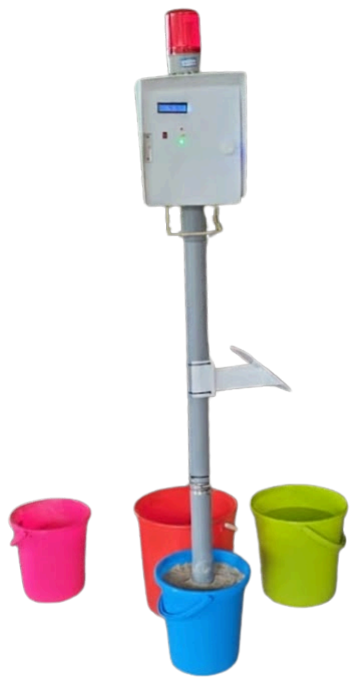
[picture p39: figure]

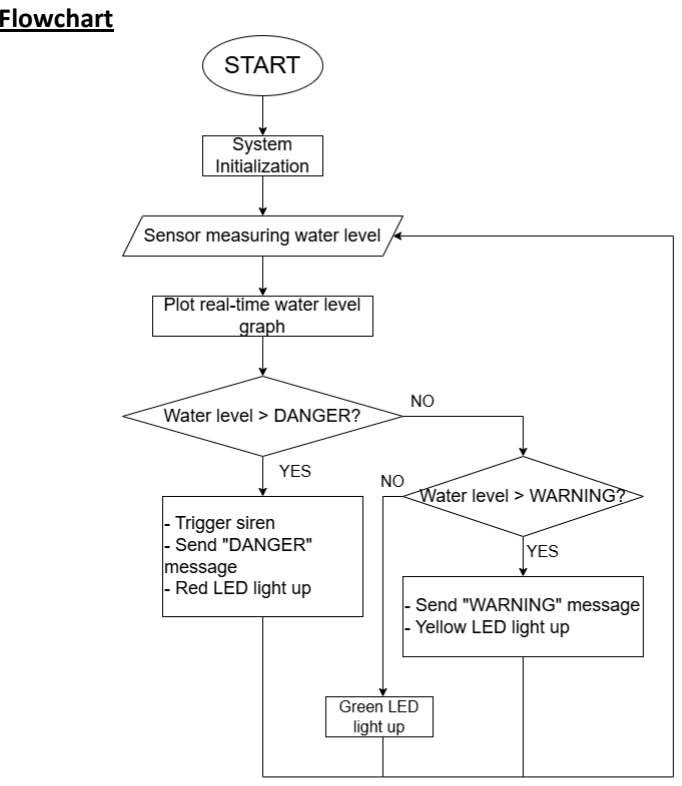
[picture p40: figure]

System Design Flowchart

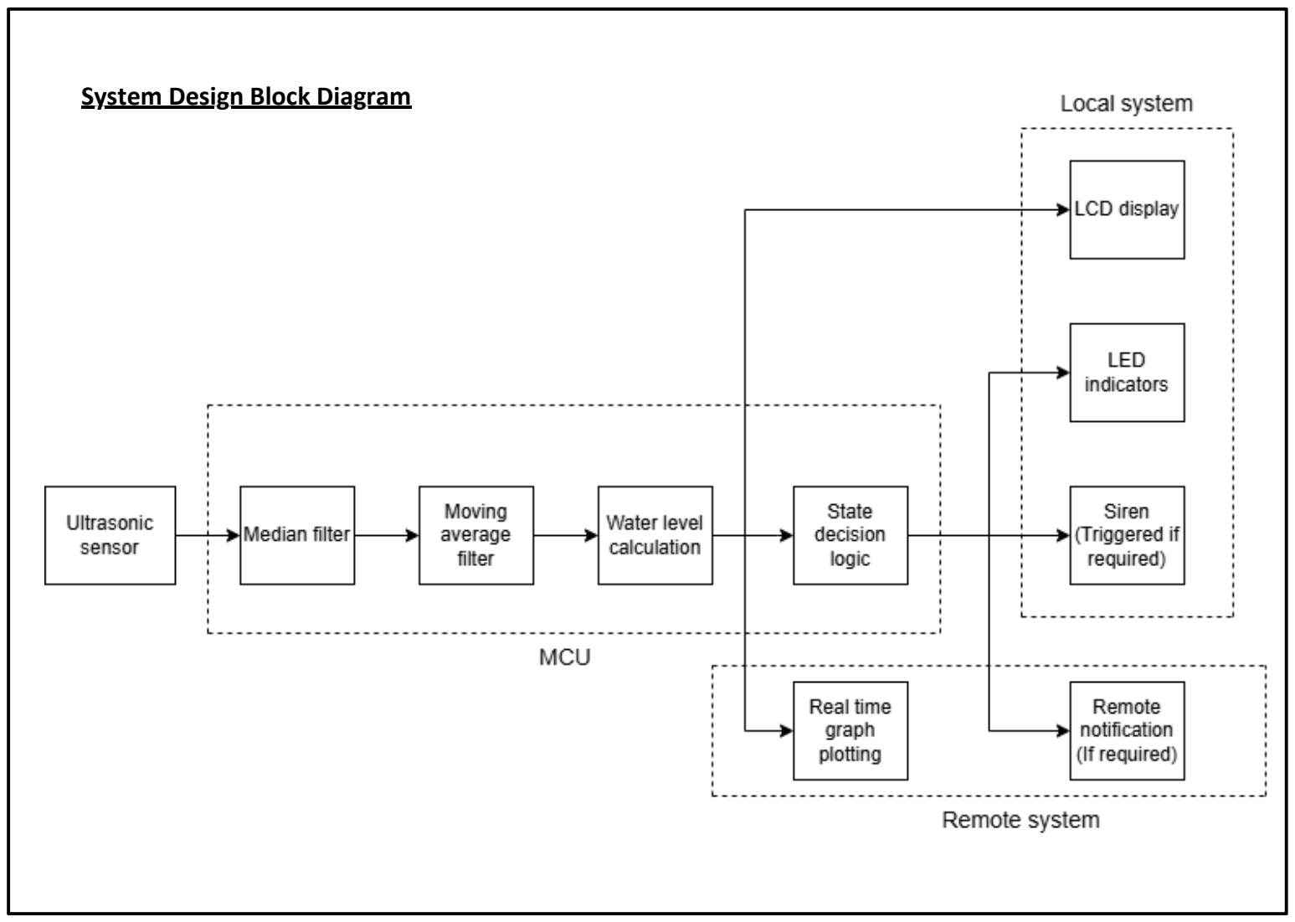
[picture p41: page 55]

System Design Block Diagram

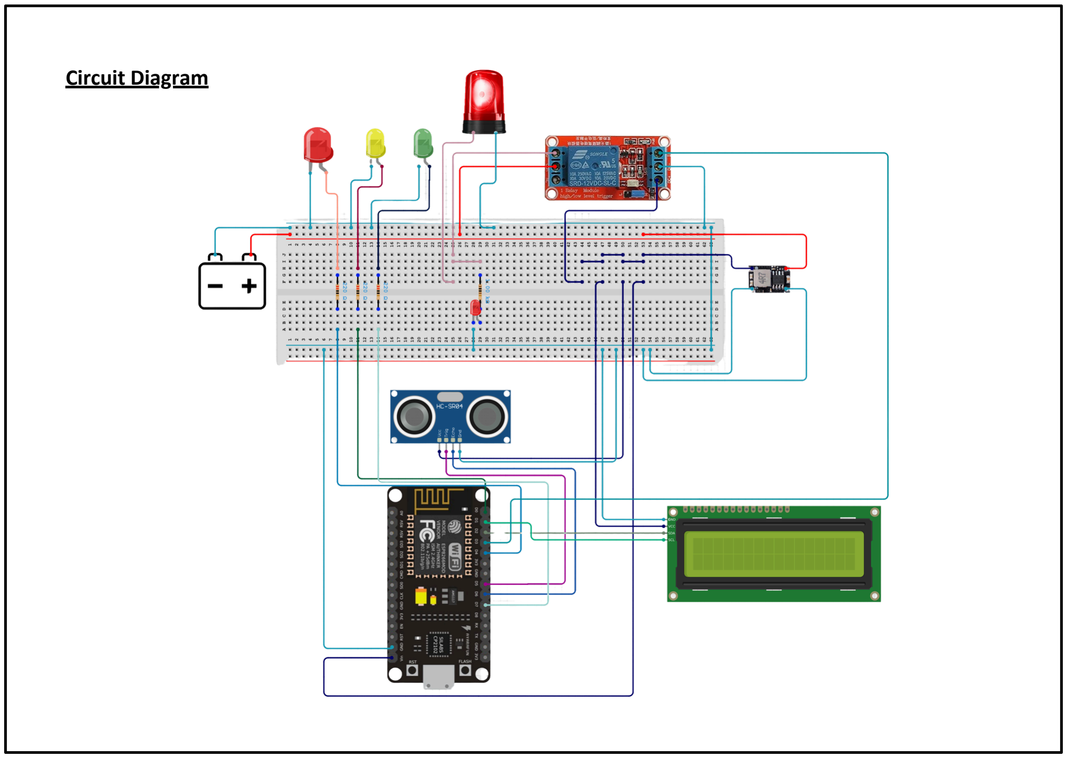
[picture p42: page 56]

Circuit Diagram

Video Link

# https://youtu.be/sLGrr76ABu4
