LawranceSim/AQUASS-Flood-Detection-Alert-System/hardware/Circuit_Diagram.png

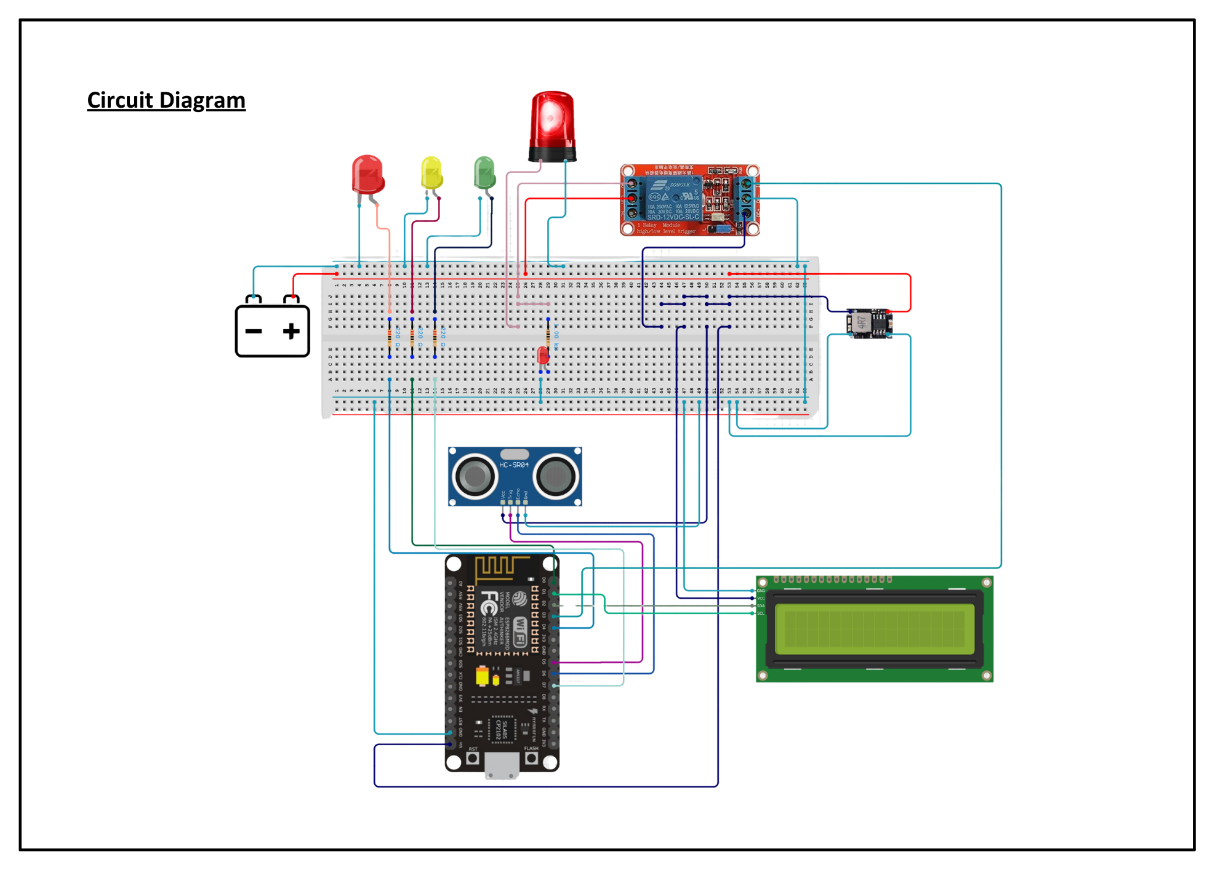
hardware/Circuit_Diagram.png
