LawranceSim/AQUASS-Flood-Detection-Alert-System/images/Prototype_Photo.png

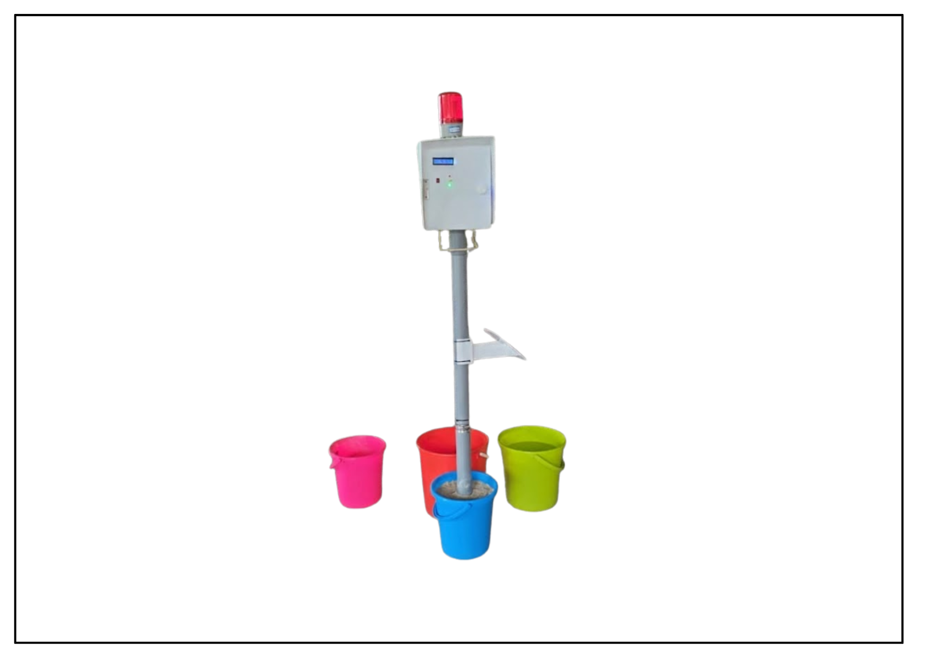
images/Prototype_Photo.png
